Boop-Noddle/20A-bipolar-current-source/kicad/H-bridge/Additionl Testing and Reports/MCC_Testing_Report.pdf

These Tests where done using a + and – 15V supplies.

### 1. The Setpoint and Monitor Voltage Relationship with Col Current

- For this part I Measured the Current in the coils using the Clamp On Ammeter as such:

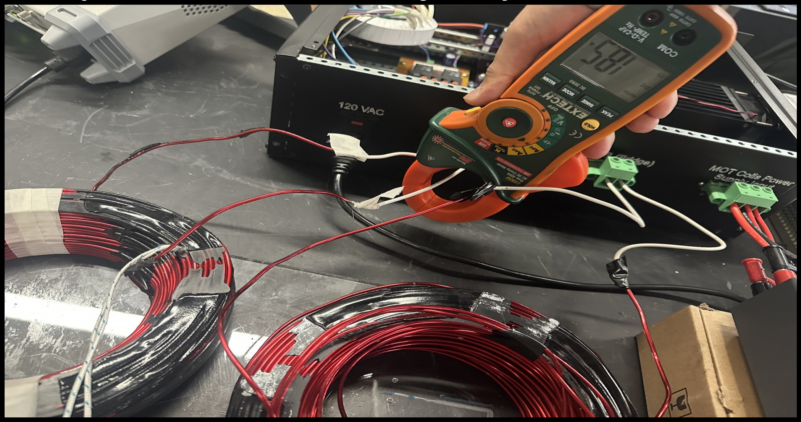
[picture p1: figure]

- Here is the data collected:

Tolerance
Sense
Resistor | 0.01 Ohms | +/- 0.1%

SetPoint
Voltage (V)

Monitor
Voltage (V)

Power Supply
Current (A)

Switching Coil
current (A)

Stationary Coil
Current (A)

Calc \w Sense
Resistor (A)
-1 | 0.21 | 2 | 2.1 | 2.1 | 2.1
-2 | 0.42 | 3.9 | 4 | 3.9 | 4.2
-3 | 0.58 | 5.9 | 6.1 | 5.9 | 5.8
-4 | 0.8 | 7.9 | 7.9 | 8 | 8
-5 | 1.02 | 9.9 | 10.6 | 10.3 | 10.2
-6 | 1.24 | 11.8 | 12.4 | 12.3 | 12.4
-7 | 1.44 | 13.8 | 14.6 | 14.4 | 14.4
-8 | 1.66 | 15.8 | 16.7 | 16.6 | 16.6
-9 | 1.86 | 17.7 | 19 | 18.6 | 18.6
-10 | 1.94 | 18.6 | 19.6 | 19.3 | 19.4

- The Relationship With SetPoint and Coil Current
- The Relationship with Monitor Voltage and Current:
-12 | -10 | -8 | -6 | -4 | -2 | 0

0

f(x) = − 2.04 x + 0.05 | 20
f(x) = − 2.01 x + 0.06 | 15
f(x) = − 2.01 x + 0.11 | 10
| 5

25

f(x) = − 1.91 x + 0.23

Coil Current Vs SetPoint

Power Supply Current (A) | Linear (Power Supply Current (A))
Switching Coil current (A) | Linear (Switching Coil current (A))
Stationary Coil Current (A) | Linear (Stationary Coil Current (A))
Using Sense Resistor (A) | Linear (Using Sense Resistor (A))

SetPoint (V)

Coil Current (A)

-2.5 | -2 | -1.5 | -1 | -0.5 | 0

0

f(x) = − 10.02 x − 0.05 | 20
f(x) = − 10.00 x | 15
f(x) = − 9.49 x + 0.13 | 10
| 5

25

f(x) = − 10.16 x − 0.05

Monitor Voltage Vs Coil Current

Power Supply Current (A) | Linear (Power Supply Current (A))
Switching Coil current (A) | Linear (Switching Coil current (A))
Stationary Coil Current (A) | Linear (Stationary Coil Current (A))
Using Sense Resistor (A) | Linear (Using Sense Resistor (A))

Monitor Voltage (V)

Coil Current (A)

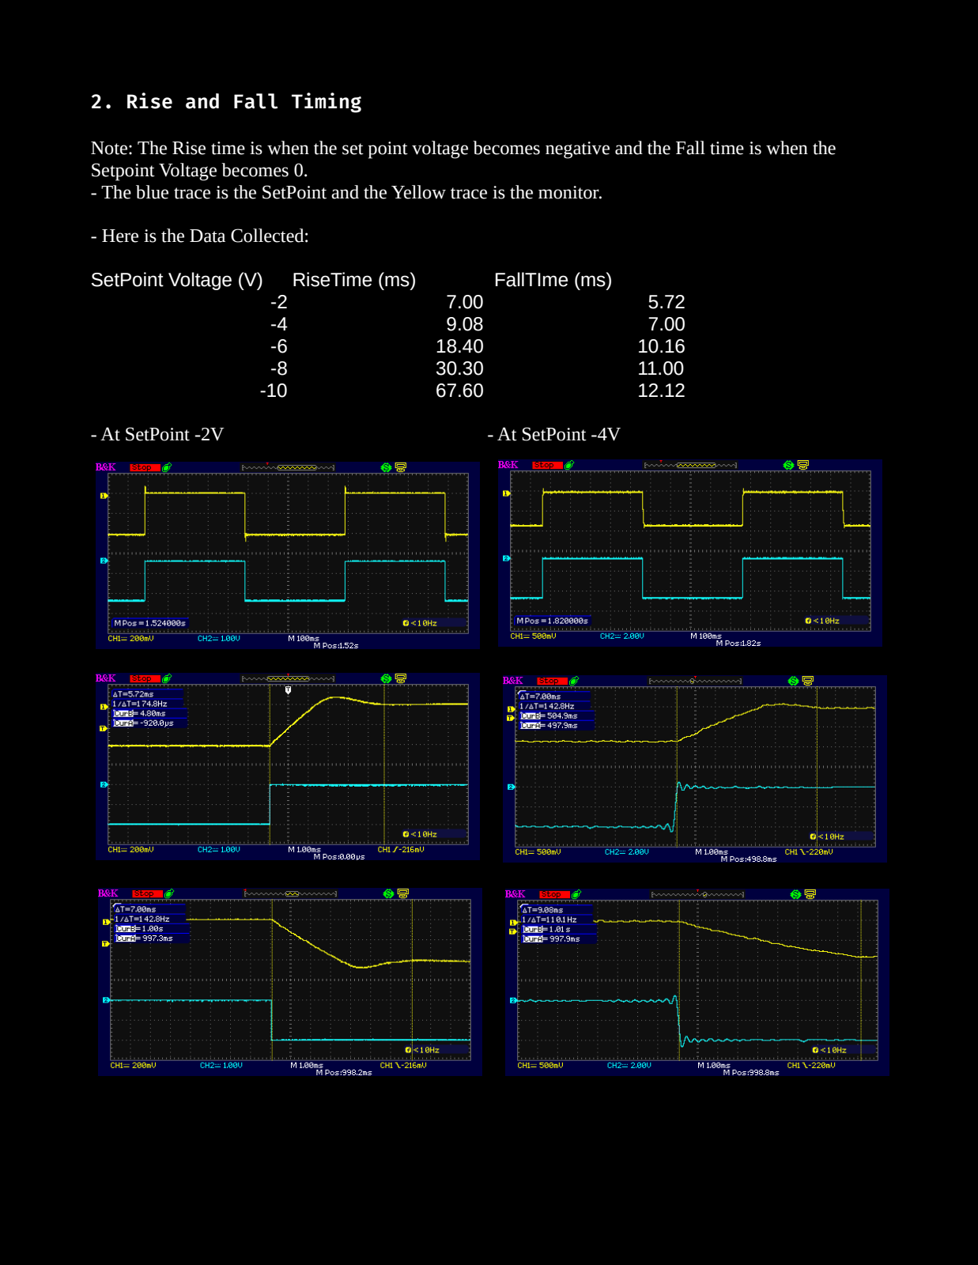
[picture p2: page 3]

### 2. Rise and Fall Timing

Note: The Rise time is when the set point voltage becomes negative and the Fall time is when the Setpoint Voltage becomes 0.
- The blue trace is the SetPoint and the Yellow trace is the monitor.
- Here is the Data Collected:
SetPoint Voltage (V) | RiseTime (ms) | FallTIme (ms)
-2 | 7.00 | 5.72
-4 | 9.08 | 7.00
-6 | 18.40 | 10.16
-8 | 30.30 | 11.00
-10 | 67.60 | 12.12
- At SetPoint -2V | | - At SetPoint -4V

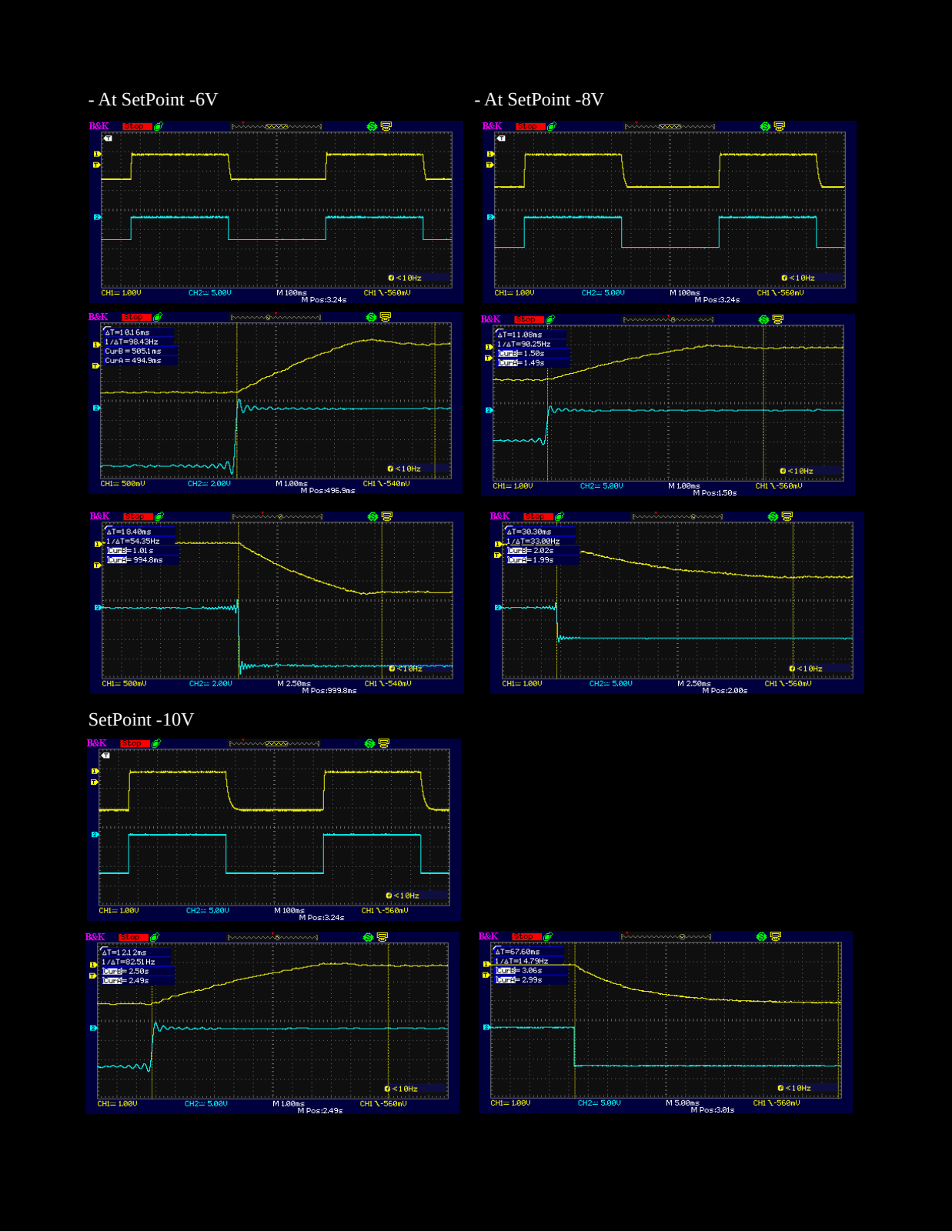
[picture p3: page 4]

- At SetPoint -6V | - At SetPoint -8V

SetPoint -10V

### 3. Portection Mechanism

In the video, I show how the protection mechnism is working. First, the function generator channel 1 is set to output a DC signal at -6V. Then I set channel 2 to output a square wave TTL with a highlevel 3.3V and low level at 0V. Once I turn channel 2 on, you can see that the proctection LED are two different colors and it is flashing because of the square wave TTL. This measn that the current is not allowed to switch rightnow because there ~ 12A flowwing through the coils right now. However, when disconnect the Setpoint the current through the coils drop to 0. The relays start to click and you can see that the protection LED’s are now both the same color. Link: https://youtu.be/TYasHYS4kVA

### 4. Noise From Monitor

Note: These measurments might not be correct, because I didn’t refresh the scope after applying a new Setpoint. To see the noise I applied a DC setpoint, then Set both channels to AC coupling and zoomed into the signal.

- When no setpoint is provided

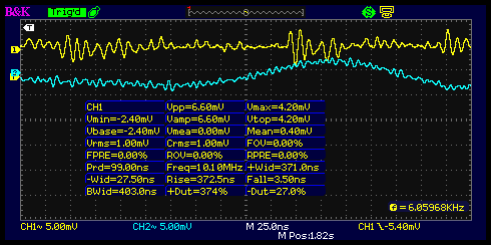
[picture p4: figure]
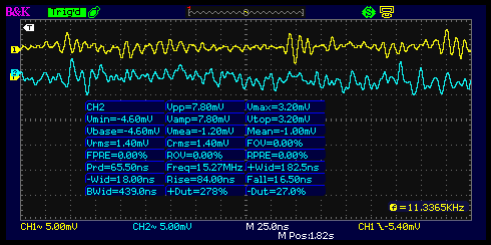
[picture p5: figure]

- At SetPoint -4V

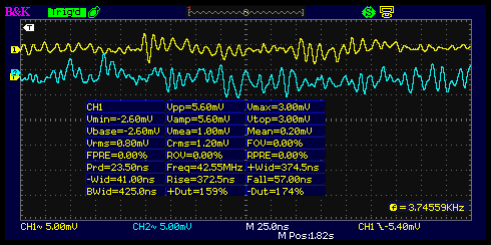
[picture p6: figure]
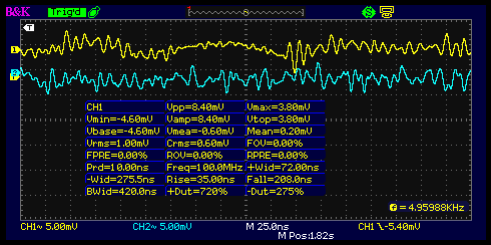
[picture p7: figure]
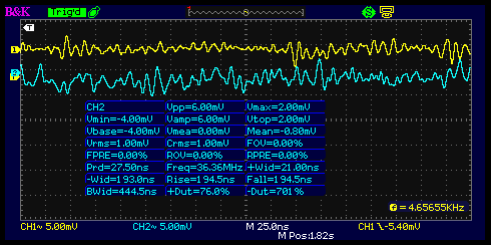
[picture p8: figure]

- At SetPoint -8V

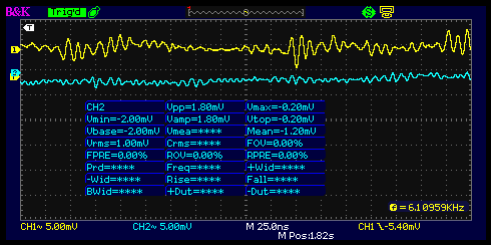
[picture p9: figure]
