Boop-Noddle/20A-bipolar-current-source/kicad/H-bridge/Additionl Testing and Reports/Measuring_L.pdf

April 18, 2025 | Inductance Measurement Report

# Measuring Inductance

## JQI Schine Lab

## April 18, 2025

# 1 Introduction

This report details the procedure and results from an experimental investigation to mea-sure the inductance of a coil constructed from 10 AWG copper wire with approximately 120 turns. Multiple measurement methodologies were employed to compare their accu-racy and reliability. The primary aim was to determine the most effective technique for

accurately measuring inductance while identifying potential sources of measurement error.

# 2 Measurements

The inductance of the coil was measured using four different scenarios. Table 1 summarizes

### the results obtained through these different methodologies. A single measurement of the

DC resistance yielded a value of 0.29 Ω.

### Table 1: Inductance Measurements Using Different Methodologies

Scenario | Method | Measured Inductance
Scenario 0 Oscilloscope pulse decay measurement | 3.80 mH
Scenario 1 RLC circuit with resonance peak analysis | 2.85 mH
Scenario 2 LC circuit with resonance peak analysis | 4.33 mH
Scenario 3 LC circuit with impedance slope method | 4.83 mH

# 3 Brief Overview

A Bode Plot 100 analyzer was utilized to conduct impedance measurements of both RLC and LC circuit configurations to determine the inductance of the coil. The measurements were performed with three different configurations: with a 1 µF capacitor (C1), with a 100 nF capacitor (C2), and without any capacitor. Although the Bode plotter features three channels, only the output channel was employed for this experiment, while channels

1 and 2 remained unused.

### Figure 1: Circuit Diagram for RLC Configuration

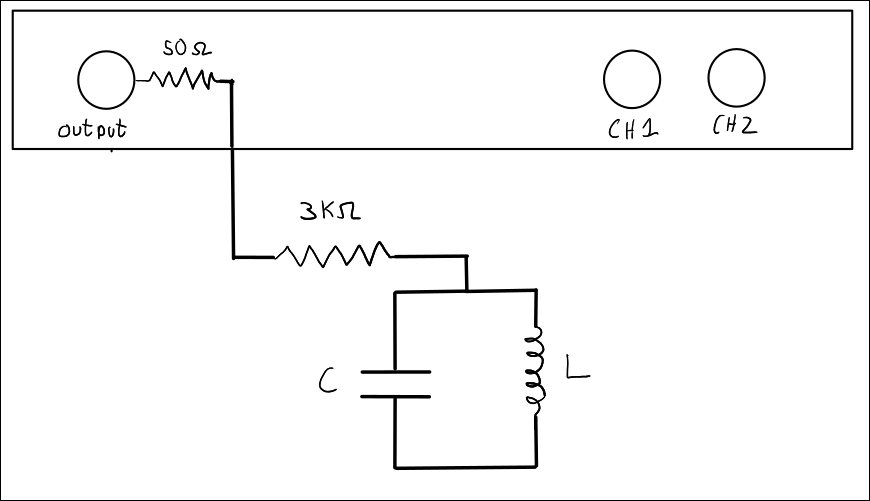
[picture p10: figure]

### Figure 2: Circuit Diagram for LC Configuration

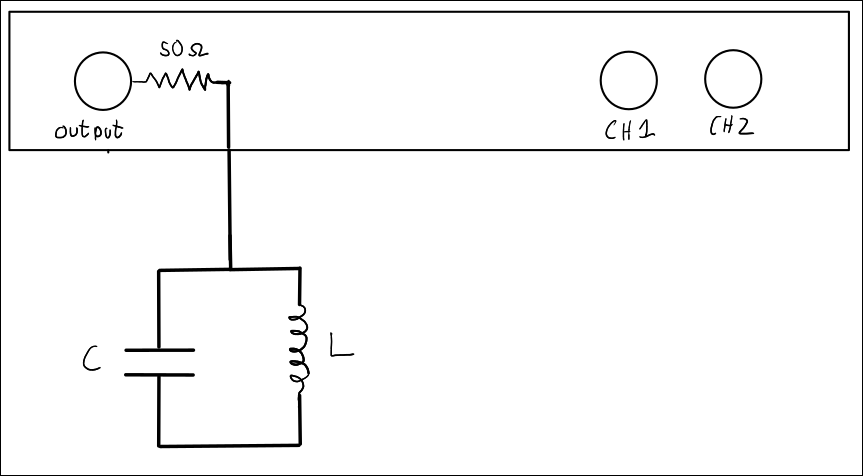
[picture p11: figure]

Since the Bode plotter software refused to connect to my Windows system, I opted to use a Linux environment. An SCPI (Standard Commands for Programmable Instruments) server was used to communicate with the Bode Plot 100 analyzer. Please refer to the automation section in https://www.omicron-lab.com/downloads/bode-analyzer-suite for more details. While the windows software provides a graphical application, the automated data collection enabled precise frequency sweeps and consistent measurement settings

across all test configurations.

# 4 Initial Planning

### Figure 3: Hand-Written Experimental Notes and Planning

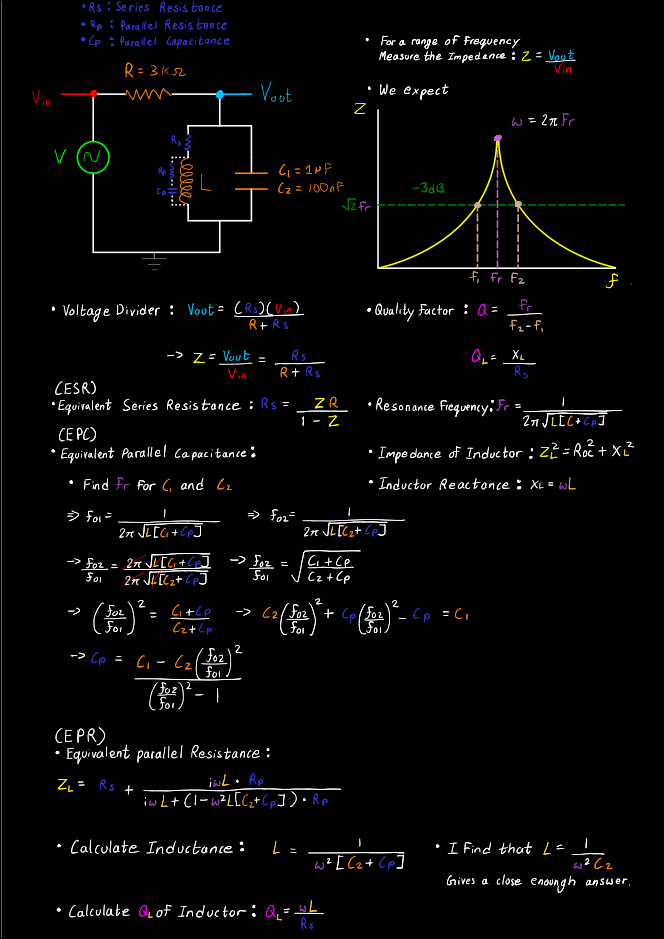
[picture p12: figure]

### The initial experimental approach utilized an RLC circuit with a 3 kΩ resistor to mea-sure the inductance of the coil. The impedance characteristics were measured across a

frequency range from 10 Hz to 1000 kHz.

### Figure 4: Impedance vs. Frequency Plot for RLC Circuit (Log-Log Scale)

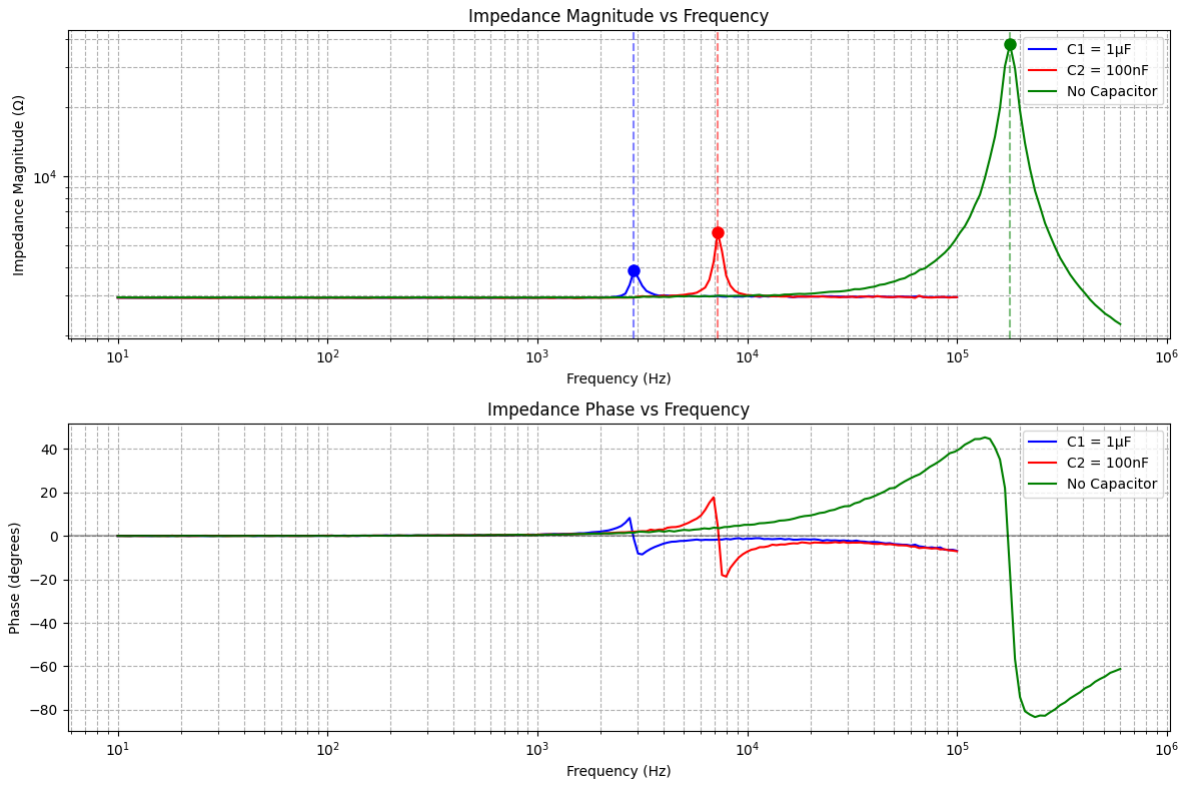
[picture p13: figure]

### Analysis of the RLC circuit data revealed that the resistive component significantly damped the system’s energy, obscuring the expected linear slope in the impedance versus

frequency plot that is characteristic of inductive components. Instead, the resonance peaks

### observed in the frequency response were used to calculate the inductance as detailed in

the hand-written notes (Figure 3).

### However, it became apparent that the Bode Plotter was measuring the impedance of

the entire RLC circuit, not just the inductor. This realization indicated that the calcula-

### tion methodology outlined in the hand-written notes would be applied incorrectly in this scenario, as it assumes that the impedance-frequency relationship is solely attributed to the inductive component. This discovery prompted a shift to an LC circuit configuration

for subsequent measurements.

# 5 Slope Method

### Figure 5: Impedance vs. Frequency Plot for LC Circuit (Log-Log Scale)

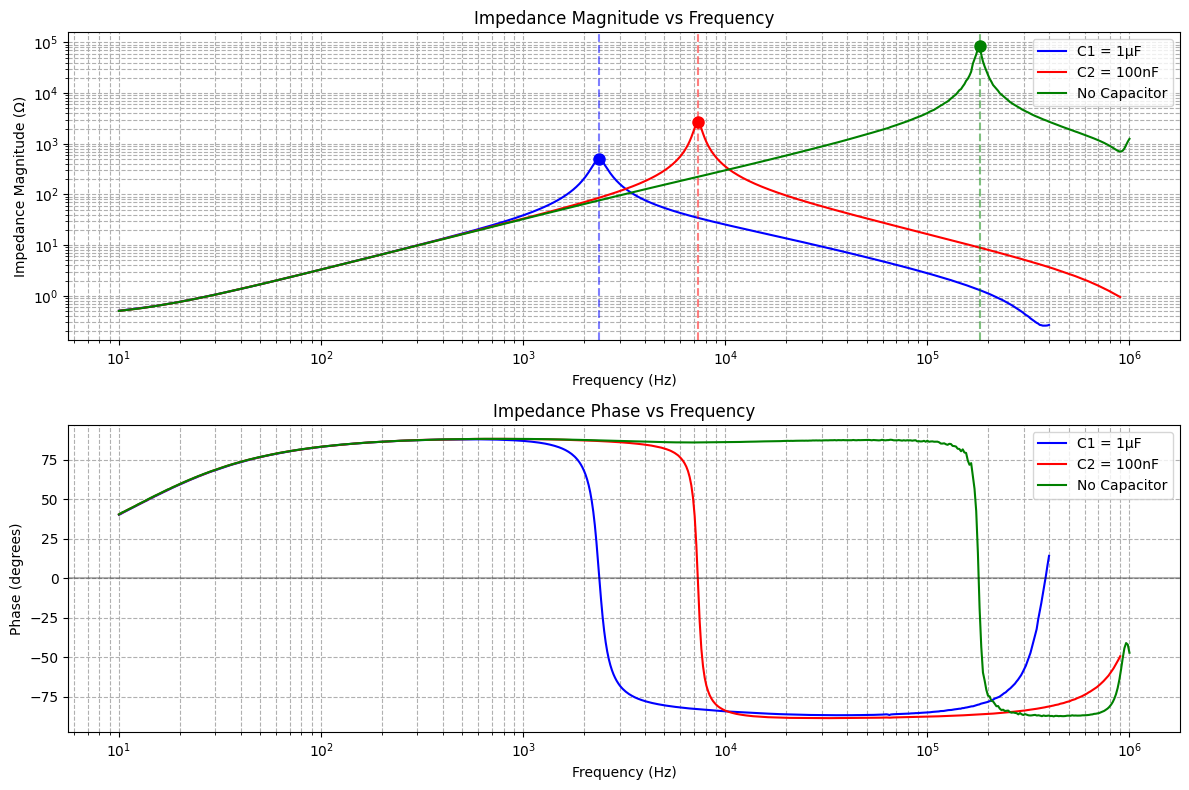
[picture p14: figure]

### The LC circuit configuration provided clearer measurement data, with all three test con-

figurations (C1, C2, and no capacitor) exhibiting the expected linear slope in the log-log

### plot of impedance versus frequency. This linear relationship in the logarithmic domain

confirms the dominant inductive behavior in the frequency range of interest.

### For the inductance calculation, the impedance data from the ”no capacitor” configura-

tion was used, as this represents the purest measurement of the inductor’s characteristics

### without the influence of capacitive elements. The slope of this line corresponds directly to the inductor’s impedance relationship:

ZL = jωL = j2πfL | (1)

### Where the magnitude of impedance increases linearly with frequency:

|ZL| = 2πfL | (2)

### Thus, the inductance can be calculated from the slope of the impedance versus frequency plot:

L =

### slope

2π

(3)

### This calculation yielded an inductance value of 4.83 mH, which is considered the most

accurate measurement from this experimental investigation.

# 6 Rough Analysis

A theoretical estimation of the inductance can be calculated using the physical dimensions

### of the coil:

### - Relative permeability (µr) = 1 (air core)

### - Number of turns (N) = 120

### - Outer diameter = 0.2 m

### - Inner diameter = 0.14 m

### - Depth = 0.04 m

### For a coil with these dimensions, the theoretical inductance can be calculated using the formula for a toroidal coil with rectangular cross-section:

L =

### µ0µrN²A

l

(4)

### Where:

### - µ0 is the permeability of free space 4π × 10⁻⁷

### - A is the cross-sectional area of the coil winding

### - l is the mean path length of the magnetic flux

### Calculating these parameters:

### Mean diameter = 0.2 + 0.14

2

= 0.17 m | (5)

### Cross-sectional area = 0.2 − 0.14

2

× 0.04 = 0.0012 m²
(6)
Mean path length = π × 0.17 = 0.534 m | (7)

### Substituting these values:

L =

### 4π × 10⁻⁷ × 1 × 120² × 0.0012

0.534

(8)

=

4π × 10⁻⁷ × 14400 × 0.0012 0.534

(9)

=

4π × 10⁻⁷ × 17.28
0.534

(10)

≈ 4.07 mH | (11)

### Comparing this theoretical value with our experimental measurements:

### - Scenario 0 (Oscilloscope): 3.80 mH (approximately 6.6% below theory)

### - Scenario 1 (RLC circuit): 2.85 mH (approximately 30.0% below theory)

### - Scenario 2 (LC resonance): 4.33 mH (approximately 6.4% above theory)

### - Scenario 3 (LC slope): 4.83 mH (approximately 18.7% above theory)

### The measurements from Scenarios 0 and 2 most closely align with the theoretical calculation, with deviations of less than 7%. The significant deviation in Scenario 1 (RLC circuit) may confirm the earlier observation that the resistor component affects the

measurement.

# 7 Code

### The following code was implemented in a Jupyter notebook for automated data collection and analysis:

## 7.1 Block 1: SCPI Server Setup

1 | # Block 1: SCPI Server Setup
2 | import pyvisa
3 | import time
4 | import matplotlib . pyplot as plt
5 | import numpy as np
6 | from scipy . optimize import curve_fit

7
8 | # *** TO DO: adapt IP address and SCPI port according to your needs ***
9 | SCPI_server_IP = ’Server IP given by SCPI server ’
10 | SCPI_Port = ’5025 ’
11 | SCPI_timeout = 20000 # milliseconds
12 | VISA_resource_name = ’TCPIP :: ’ + SCPI_server_IP + ’:: ’ + SCPI_Port + ’::
| SOCKET ’

13
14 | # Measurement configuration
15 | Start_frequency = ’10 Hz ’
16 | Stop_frequency = ’1000 KHz ’
17 | Number_of_measurement_points = 601 # the minimum amount of measurement
| points is 2!
18 | Sweep_type = ’LOG ’
19 | Receiver_bandwidth = ’300 Hz ’

20
21 | def perform_measurement () :
22 | start_time = time . time ()
23 | print (
24 | ’Trying to connect to VISA resource : ’ + VISA_resource_name +
25 | ’. Be sure that IP address and port number are correct !’)
26 | visaSession = pyvisa . ResourceManager () . open_resource (
| VISA_resource_name )
27 | visaSession . timeout = SCPI_timeout
28 | visaSession . read_termination = ’\n’
29 | print (’SCPI client connected to SCPI server : ’ + visaSession . query ("
| *IDN?") )

30
31 | lockOk = visaSession . query (": SYST : LOCK :REQ ?")
32 | if lockOk != "1":
33 | print (" Locking was not successful , exiting !")
34 | return None , None , None
35 | else :
36 | print (" Locking was successful !")

37
38 | try :
39 | ### Here comes the measurement configuration data for
| measurement sweep
40 | visaSession . write (’: SENS : FREQ : STAR ’ + Start_frequency )
41 | visaSession . write (’: SENS : FREQ : STOP ’ + str( Stop_frequency ) )
42 | visaSession . write (’: SENS : SWE: POIN ’ + str(
| Number_of_measurement_points ) )
43 | visaSession . write (’: SENS : SWE: TYPE ’ + Sweep_type )
44 | visaSession . write (’: SENS : BAND ’ + Receiver_bandwidth )

45
46 | # configuring ’one - port ’ impedance measurement
47 | visaSession . write (’: CALC : PAR: DEF Z’)
48 | # linear magnitude in Ohms + phase (deg)
49 | visaSession . write (": CALC : FORM SLIN ")

50
51 | # Intializes trigger system to use BUS as source
52 | visaSession . write (’: TRIG : SOUR BUS ’)
53 | # Sets the trigger in continous mode .
54 | visaSession . write (’: INIT : CONT ON ’)
55 | visaSession . write (’: TRIG : SING ’)

56
57 | # This command waits for all pending operations to finish
58 | visaSession . query (’* OPC?’)

59
60 | # Query the measurement results
61 | allResults = visaSession . query (": CALC : DATA : SDAT ?")
62 | frequencyValues = visaSession . query (": SENS : FREQ : DATA ?")

63
64 | # Magnitude and phase from the results
65 | allResults_list_raw = list (map(float , allResults . split (",") ) )
66 | magnitude_raw = allResults_list_raw [0:
Number_of_measurement_points ]
67 | phase_raw = allResults_list_raw [ Number_of_measurement_points :len
( allResults_list_raw ) ]

68
69 | # Same procedure with frequency raw data to list and eventually
to array
70 | freq_list_raw = list (map(float , frequencyValues . split (",") ) )

71
72 | # Printing just the first results of the measurement cycle as
example
73 | print (" Frequency : " + str( freq_list_raw [0]) + " Hz;" + "\
tMagnitude : "
74 | + str( magnitude_raw [0])
75 | + " | ;" + "\ tPhase : " + str( phase_raw [0]) + " | ")

76
77 | except Exception as e :
78 | print ( f"An error occurred : {e}")
79 | return None , None , None

80
81 | finally :
82 | # Release the device
83 | relOK = visaSession . query (’: SYSTem : LOCK : RELease ?’)
84 | visaSession . query (’* OPC?’)
85 | if relOK != "1":
86 | print (" Releasing was not successful , check the availability
of the device !")
87 | else :
88 | print (" Releasing was successful !")

89
90 | visaSession . close ()
91 | print (" --- Measurement time : %s seconds ---" % ( time . time () -
| start_time ) )

92
93 | return freq_list_raw , magnitude_raw , phase_raw

### Listing 1: SCPI Server Setup and Connection

## 7.2 Block 2: First Measurement with C1 = 1F

1 | # Block 2: First Measurement with C1 = 1 F
2 | print (" Running measurement with C1 = 1 F ")
3 | freq1 , mag1 , phase1 = perform_measurement ()
4 | # save to csv file
5 | np . savetxt ("1uF. csv", np . column_stack (( freq1 , mag1 , phase1 ) ) , delimiter =
| ",", header =" Frequency , Magnitude , Phase ", comments =’’)

### Listing 2: First Measurement with C1

## 7.3 Block 3: Second Measurement with C2 = 100nF

1 | # Block 3: Second Measurement with C2 = 100 nF
2 | print ("\ nRunning measurement with C2 = 100 nF")
3 | freq2 , mag2 , phase2 = perform_measurement ()
4 | # save to csv file
5 | np . savetxt (" 100 nF. csv ", np . column_stack (( freq2 , mag2 , phase2 ) ) ,
| delimiter =",", header =" Frequency , Magnitude , Phase ", comments =’’)

### Listing 3: Second Measurement with C2

## 7.4 Block 4: Third Measurement with No Capacitor

1 | # Block 3.1: Third Measurement with no capacitor
2 | print ("\ nRunning measurement with no capacitor ")
3 | freq3 , mag3 , phase3 = perform_measurement ()
4 | # Save to csv file
5 | np . savetxt (" NoCap . csv", np . column_stack (( freq3 , mag3 , phase3 ) ) ,
| delimiter =",", header =" Frequency , Magnitude , Phase ", comments =’’)
6 | plt . figure ()
7 | plt . loglog ( freq3 , mag3 )
8 | plt . show ()

### Listing 4: Third Measurement with No Capacitor

## 7.5 Block 5: Analysis and Plotting

1 | # Block 4: Analysis and Plotting
2 | import numpy as np
3 | import matplotlib . pyplot as plt

4
5 | fre1 = np . loadtxt ("1uF.csv ", delimiter =",", skiprows =1)
6 | fre2 = np . loadtxt ("100 nF.csv ", delimiter =",", skiprows =1)
7 | fre3 = np . loadtxt (" NoCap .csv ", delimiter =",", skiprows =1)
8 | freq1 = [ n for n in fre1 [: ,0]]
9 | mag1 = [ n for n in fre1 [: ,1]]
10 | phase1 = [ n for n in fre1 [: ,2]]
11 | freq2 = [ n for n in fre2 [: ,0]]
12 | mag2 = [ n for n in fre2 [: ,1]]
13 | phase2 = [ n for n in fre2 [: ,2]]
14 | freq3 = [ n for n in fre3 [: ,0]]
15 | mag3 = [ n for n in fre3 [: ,1]]
16 | phase3 = [ n for n in fre3 [: ,2] ]

18 # Find resonant frequencies by finding MAXIMUM impedance magnitude (for parallel resonance )
19 | # Find maximum impedance ( peak in the bode plot )
20 | max_idx1 = mag1 . index (max( mag1 ) )
21 | fr1 = freq1 [ max_idx1 ]
22 | z_max1 = mag1 [ max_idx1 ]
23 | print ( f" Resonant frequency (C1): {fr1 :.2f} Hz , Maximum impedance : {
z_max1 :.2 f} | ")

24
25 | # Find maximum impedance ( peak in the bode plot )
26 | max_idx2 = mag2 . index (max( mag2 ) )
27 | fr2 = freq2 [ max_idx2 ]
28 | z_max2 = mag2 [ max_idx2 ]
29 | print ( f" Resonant frequency (C2): {fr2 :.2f} Hz , Maximum impedance : {
z_max2 :.2 f} | ")

30
31 | # Find maximum impedance ( peak in the bode plot )
32 | max_idx3 = mag3 . index (max( mag3 ) )
33 | fr3 = freq3 [ max_idx3 ]
34 | z_max3 = mag3 [ max_idx3 ]
35 | print ( f" Resonant frequency (No Capacitor ): {fr3 :.2f} Hz , Maximum
impedance : { z_max3 :.2f} | ")

36

37
38 | ’’’
39 | Invalid way of calculating the EPC and L

40
41 | # Calculate component values if resonant frequencies were found
42 | if fr1 and fr2:
43 | # Given values
44 | C1 = 1e -6 | # 1 F
45 | C2 = 100e -9 | # 100 nF

46
47 | # Calculate inductance using equation
48 | # fr = 1/(2 | (L[C+Cp ]))
49 | # Two measurements with different capacitors allow us to solve for L

50
51 | # Using the formula derived
52 | # (fr2/fr1)^2 = (C1+Cp)/( C2+Cp)
53 | # Solve for Cp ( Equivalent Parallel Capacitance )
54 | ratio_sq = (fr2/fr1)**2
55 | Cp = (C1 - ratio_sq * C2) / ( ratio_sq - 1)
56 | print (f" Equivalent Parallel Capacitance (Cp): {Cp *1 e9 :.2f} nF ")

57
58 | # Calculate inductance using fr1 and total capacitance (C1 + Cp)
59 | L = 1 / ((2 * np.pi * fr1)**2 * (C1 + Cp))
60 | print (f" Inductance (L): {L*1 e3 :.2f} mH ")

61
62 | # Calculate Slope of the plot at 100 Hz to 300 Hz by fitting to a line

63

64
65 | if fr3:
66 | L_wc = 1 / (2 * np.pi * fr3 )
67 | print (f" Inductance without cap ( L_wc ): {L*1 e3 :.2f} mH ")

68
69 | # using fr = 1/(2 | (LC)) where Cp = C
70 | Cp_wc = 1 / (4 * (np.pi **2) * (fr3 **2) * L_wc )
71 | print (f" Parasitic Capacitance ( Cp_wc ): { Cp_wc *1 e9 :.2f} nF ")

72 | ’’’
73 | # Use the slope of the plot to calculate the inductance
74 | def calculate_inductance_from_slope ( freq , mag , freq_start , freq_end ) :
75 | # Find indices for the frequency range
76 | indices = [ i for i , f in enumerate ( freq ) if freq_start <= f <=
freq_end ]

77
78 | # Extract the relevant portions of the data
79 | freq_range = [ freq [ i ] for i in indices ]
80 | mag_range = [ mag [ i ] for i in indices ]

81
82 | # Fit a line to the data
83 | coeffs = np . polyfit ( freq_range , mag_range , 1)
84 | slope = coeffs [0]
85 | intercept = coeffs [1]

86
87 | # For an inductor , |Z| = | L | = 2 fL
88 | # L = slope / (2 | )
89 | L = slope / (2 * np . pi )

90
91 | return L , slope , intercept , freq_range , mag_range

92
93 | # Set frequency range for analysis
94 | freq_start = 10**2 | # Hz
95 | freq_end = 10**4 | # Hz

96
97 | # Choose which dataset to use ( ’C1 ’, ’C2 ’, or ’noCapacitor ’)
98 | dataset = ’noCapacitor ’ | # Change this to use different dataset

99
100 | # Calculate inductance based on chosen dataset
101 | if dataset == ’C1 ’:
102 | L , slope , intercept , freq_range , mag_range =
calculate_inductance_from_slope (
103 | freq1 , mag1 , freq_start , freq_end )
104 | label = "C1 = 1 F "
105 | elif dataset == ’C2 ’:
106 | L , slope , intercept , freq_range , mag_range =
calculate_inductance_from_slope (
107 | freq2 , mag2 , freq_start , freq_end )
108 | label = "C2 = 100 nF"
109 | elif dataset == ’noCapacitor ’:
110 | L , slope , intercept , freq_range , mag_range =
calculate_inductance_from_slope (
111 | freq3 , mag3 , freq_start , freq_end )
112 | label = "No Capacitor "

113
114 | # Print results
115 | if L is not None :
116 | print ( f"\ nInductance calculation using { label } ( slope between {
freq_start } -{ freq_end } Hz):")
117 | print ( f" | Linear fit: |Z| = { slope :.4f}f + { intercept :.4f}")
118 | print ( f" | Slope : { slope :.4f} | /Hz")
119 | print ( f" | Inductance : {L*1 e3 :.2f} mH")
120 | else :
121 | print ( f" Could not calculate inductance for { label } in range {
freq_start } -{ freq_end } Hz")

122
123 | # w = 2 f | measured DC Resistance = mdr # Ohm

124 | mdr = 0.29
125 | w1 = 2 * np . pi * fr1
126 | w2 = 2 * np . pi * fr2
127 | w3 = 2 * np . pi * fr3
128 | Q1 = w1 * L / mdr
129 | print ("Q factor with C1 = 1 F : ", Q1 )
130 | Q2 = w2 * L / mdr
131 | print ("Q factor with C2 = 100 nF: ", Q2 )
132 | Q3 = w3 * L / mdr
133 | print ("Q factor with no capacitor : ", Q3 )

134
135 | # Plot the results
136 | plt . figure ( figsize =(12 , 8) )

137
138 | # Plot 1: Magnitude vs Frequency
139 | plt . subplot (2 , 1 , 1)
140 | if freq1 and mag1 :
141 | plt . loglog ( freq1 , mag1 , ’b-’, label =’C1 = 1 F ’)
142 | plt . axvline ( x = fr1 , color =’b’, linestyle =’--’, alpha =0.5)
143 | plt . plot ( fr1 , z_max1 , ’bo ’, markersize =8)

144

145
146 | if freq2 and mag2 :
147 | plt . loglog ( freq2 , mag2 , ’r-’, label =’C2 = 100 nF ’)
148 | plt . axvline ( x = fr2 , color =’r’, linestyle =’--’, alpha =0.5)
149 | plt . plot ( fr2 , z_max2 , ’ro ’, markersize =8)

150
151 | if freq3 and mag3 :
152 | plt . loglog ( freq3 , mag3 , ’g-’, label =’No Capacitor ’)
153 | plt . axvline ( x = fr3 , color =’g’, linestyle =’--’, alpha =0.5)
154 | plt . plot ( fr3 , z_max3 , ’go ’, markersize =8)

155

156
157 | plt . grid ( True , which =" both ", ls =" --")
158 | plt . xlabel (’Frequency (Hz)’)
159 | plt . ylabel (’Impedance Magnitude ( | )’)
160 | plt . title (’Impedance Magnitude vs Frequency ’)
161 | plt . legend ()

162
163 | # Plot 2: Phase vs Frequency
164 | plt . subplot (2 , 1 , 2)
165 | if freq1 and phase1 :
166 | plt . semilogx ( freq1 , phase1 , ’b-’, label =’C1 = 1 F ’)
167 | if freq2 and phase2 :
168 | plt . semilogx ( freq2 , phase2 , ’r-’, label =’C2 = 100 nF ’)
169 | if freq3 and phase3 :
170 | plt . semilogx ( freq3 , phase3 , ’g-’, label =’No Capacitor ’)
171 | plt . grid ( True , which =" both ", ls =" --")
172 | plt . xlabel (’Frequency (Hz)’)
173 | plt . ylabel (’Phase ( degrees )’)
174 | plt . title (’Impedance Phase vs Frequency ’)
175 | plt . axhline ( y =0 , color =’k’, linestyle =’-’, alpha =0.3)
176 | plt . legend ()
177 | plt . tight_layout ()
178 | plt . show ()

### Listing 5: Analysis and Plotting
