Boop-Noddle/20A-bipolar-current-source/kicad/H-bridge/Additionl Testing and Reports/RiseFallScopeData/S10.CSV

Source | CH1 | CH2
Second | Volt | Volt
3.99400000000 | -0.04000 | 0.00
3.99439975000 | -0.04000 | 0.00
3.99479975000 | -0.04000 | -0.20000
3.99520000000 | -0.04000 | -0.20000
3.99560000000 | -0.04000 | 0.00
3.99599975000 | -0.04000 | -0.20000
3.99640000000 | -0.04000 | -0.20000
3.99680000000 | -0.04000 | 0.00
3.99720000000 | -0.04000 | -0.20000
3.99759975000 | -0.04000 | 0.00
3.99800000000 | -0.04000 | 0.00
3.99840000000 | -0.04000 | 0.00
3.99879975000 | -0.04000 | -0.20000
3.99919975000 | -0.04000 | -0.20000
3.99960000000 | -0.04000 | 0.00
4.00000000000 | -0.04000 | 0.00
4.00040000000 | -0.08000 | 0.00
4.00080025000 | -0.04000 | 0.00
4.00119975000 | -0.04000 | 0.00
4.00159975000 | -0.04000 | -0.20000
4.00199975000 | -0.04000 | -0.20000
4.00240000000 | -0.04000 | 0.00
4.00280000000 | -0.04000 | 0.00
4.00320000000 | -0.08000 | -0.20000
4.00360000000 | -0.04000 | 0.00
4.00399975000 | -0.04000 | 0.00
4.00439975000 | -0.04000 | 0.00
4.00479975000 | -0.04000 | 0.00
4.00520000000 | -0.04000 | -0.20000
4.00560000000 | -0.04000 | -0.20000
4.00600000000 | -0.04000 | 0.00
4.00640000000 | -0.04000 | -0.20000
4.00679975000 | -0.08000 | 0.00
4.00719975000 | -0.08000 | -0.20000
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
