Boop-Noddle/20A-bipolar-current-source/kicad/H-bridge/Additionl Testing and Reports/RiseFallScopeData/S2.CSV

Source | CH1 | CH2
Second | Volt | Volt
-1.06600000000 | 0.02400 | 0.00
-1.06559987500 | 0.02400 | -0.04000
-1.06520000000 | 0.02400 | 0.00
-1.06480000000 | 0.02400 | -0.04000
-1.06440000000 | 0.02400 | 0.00
-1.06400000000 | 0.02400 | -0.04000
-1.06360000000 | 0.02400 | 0.00
-1.06320000000 | 0.02400 | 0.00
-1.06279987500 | 0.02400 | 0.00
-1.06240000000 | 0.02400 | -0.04000
-1.06199987500 | 0.02400 | 0.00
-1.06160000000 | 0.02400 | 0.00
-1.06120000000 | 0.02400 | 0.00
-1.06080000000 | 0.02400 | 0.00
-1.06040000000 | 0.02400 | 0.00
-1.06000000000 | 0.02400 | 0.00
-1.05960000000 | 0.02400 | 0.00
-1.05919987500 | 0.02400 | 0.00
-1.05880000000 | 0.02400 | -0.04000
-1.05839987500 | 0.02400 | 0.00
-1.05800000000 | 0.02400 | 0.00
-1.05760000000 | 0.02400 | 0.00
-1.05720000000 | 0.02400 | 0.00
-1.05680000000 | 0.02400 | 0.00
-1.05640000000 | 0.02400 | 0.00
-1.05600000000 | 0.02400 | -0.04000
-1.05559987500 | 0.02400 | 0.00
-1.05520000000 | 0.02400 | 0.00
-1.05479987500 | 0.02400 | 0.00
-1.05440000000 | 0.02400 | 0.00
-1.05400000000 | 0.03200 | 0.00
-1.05360000000 | 0.02400 | -0.04000
-1.05320000000 | 0.02400 | 0.00
-1.05280000000 | 0.02400 | 0.00
-1.05240000000 | 0.02400 | 0.00
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
