Boop-Noddle/20A-bipolar-current-source/kicad/H-bridge/Additionl Testing and Reports/RiseFallScopeData/S4.CSV

Source | CH1 | CH2
Second | Volt | Volt
-0.99600000000 | 0.04000 | -0.08000
-0.99560000000 | 0.04000 | 0.00
-0.99520000000 | 0.04000 | 0.00
-0.99480000000 | 0.02000 | 0.00
-0.99439993750 | 0.02000 | 0.00
-0.99399993750 | 0.02000 | 0.00
-0.99359993750 | 0.02000 | 0.00
-0.99320000000 | 0.04000 | 0.00
-0.99280000000 | 0.04000 | -0.08000
-0.99240000000 | 0.02000 | -0.08000
-0.99200000000 | 0.02000 | -0.08000
-0.99160000000 | 0.02000 | -0.08000
-0.99120000000 | 0.02000 | -0.08000
-0.99079993750 | 0.02000 | -0.08000
-0.99039993750 | 0.02000 | -0.08000
-0.98999993750 | 0.02000 | 0.00
-0.98960000000 | 0.02000 | -0.08000
-0.98920000000 | 0.02000 | -0.08000
-0.98880000000 | 0.04000 | 0.00
-0.98840000000 | 0.04000 | -0.08000
-0.98800000000 | 0.02000 | -0.08000
-0.98760000000 | 0.04000 | 0.00
-0.98719993750 | 0.02000 | -0.08000
-0.98679993750 | 0.04000 | -0.08000
-0.98639993750 | 0.04000 | -0.08000
-0.98600000000 | 0.04000 | -0.08000
-0.98560000000 | 0.02000 | -0.08000
-0.98520000000 | 0.02000 | -0.08000
-0.98480000000 | 0.02000 | -0.08000
-0.98440000000 | 0.02000 | 0.00
-0.98399993750 | 0.02000 | 0.00
-0.98359993750 | 0.02000 | -0.08000
-0.98319993750 | 0.02000 | 0.00
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
