Boop-Noddle/20A-bipolar-current-source/kicad/H-bridge/Additionl Testing and Reports/RiseFallScopeData/S6.CSV

Source | CH1 | CH2
Second | Volt | Volt
-0.98600000000 | 0.02000 | -0.08000
-0.98560000000 | 0.02000 | -0.08000
-0.98520000000 | 0.02000 | 0.00
-0.98480000000 | 0.02000 | 0.00
-0.98440000000 | 0.02000 | -0.08000
-0.98399993750 | 0.02000 | -0.08000
-0.98359993750 | 0.02000 | 0.00
-0.98319993750 | 0.02000 | -0.08000
-0.98279993750 | 0.02000 | 0.00
-0.98240000000 | 0.02000 | -0.08000
-0.98200000000 | 0.02000 | 0.00
-0.98160000000 | 0.02000 | -0.08000
-0.98120000000 | 0.02000 | 0.00
-0.98080000000 | 0.02000 | 0.00
-0.98039993750 | 0.02000 | -0.08000
-0.97999993750 | 0.04000 | 0.00
-0.97959993750 | 0.02000 | -0.08000
-0.97919993750 | 0.02000 | 0.00
-0.97880000000 | 0.02000 | -0.08000
-0.97840000000 | 0.02000 | -0.08000
-0.97800000000 | 0.02000 | -0.08000
-0.97760000000 | 0.02000 | -0.08000
-0.97720000000 | 0.02000 | -0.08000
-0.97679993750 | 0.02000 | -0.08000
-0.97639993750 | 0.02000 | -0.08000
-0.97599993750 | 0.02000 | -0.08000
-0.97560000000 | 0.02000 | -0.08000
-0.97520000000 | 0.04000 | -0.08000
-0.97480000000 | 0.04000 | -0.08000
-0.97440000000 | 0.04000 | 0.00
-0.97400000000 | 0.02000 | -0.08000
-0.97360000000 | 0.04000 | -0.08000
-0.97319993750 | 0.02000 | -0.08000
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
