Boop-Noddle/20A-bipolar-current-source/kicad/H-bridge/Additionl Testing and Reports/RiseFallScopeData/S8.CSV

Source | CH1 | CH2
Second | Volt | Volt
1.51400000000 | -0.04000 | -0.20000
1.51440000000 | -0.04000 | -0.20000
1.51480000000 | -0.04000 | 0.00
1.51520000000 | -0.04000 | 0.00
1.51560000000 | -0.04000 | 0.00
1.51599987500 | -0.04000 | 0.00
1.51640000000 | -0.04000 | 0.20000
1.51679987500 | -0.04000 | 0.00
1.51720000000 | -0.04000 | 0.00
1.51760000000 | -0.04000 | 0.00
1.51800000000 | -0.04000 | -0.20000
1.51840000000 | -0.04000 | 0.00
1.51880000000 | -0.04000 | 0.00
1.51920000000 | -0.04000 | 0.00
1.51959987500 | -0.04000 | -0.20000
1.52000000000 | -0.04000 | 0.00
1.52039987500 | -0.04000 | 0.00
1.52080000000 | -0.04000 | 0.00
1.52120000000 | -0.04000 | 0.00
1.52160000000 | -0.04000 | 0.00
1.52200000000 | -0.04000 | 0.00
1.52239987500 | -0.04000 | 0.00
1.52280000000 | -0.04000 | 0.00
1.52319987500 | -0.04000 | 0.00
1.52360000000 | -0.04000 | 0.00
1.52399987500 | -0.04000 | 0.00
1.52440000000 | -0.04000 | 0.00
1.52480000000 | -0.04000 | 0.00
1.52520000000 | -0.04000 | 0.00
1.52560000000 | -0.04000 | 0.00
1.52599987500 | 0.00 | 0.00
1.52640000000 | -0.04000 | 0.00
1.52679987500 | -0.04000 | -0.20000
1.52720000000 | -0.04000 | 0.00
1.52759987500 | -0.04000 | 0.00
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
