Boop-Noddle/20A-bipolar-current-source/kicad/H-bridge/Additionl Testing and Reports/MeausringInductance/Pulse_Decay.png

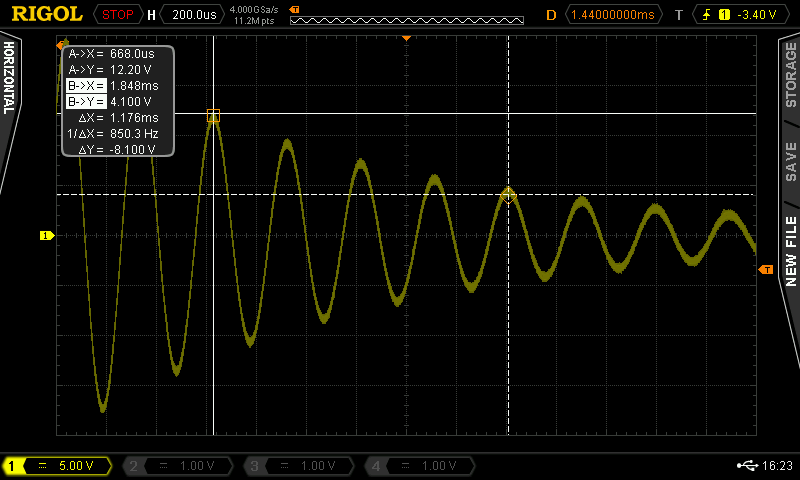
kicad/H-bridge/Additionl Testing and Reports/MeausringInductance/Pulse_Decay.png
