Boop-Noddle/20A-bipolar-current-source/kicad/H-bridge/Additionl Testing and Reports/UnipolarFetBoard/Fet_with_Network.png

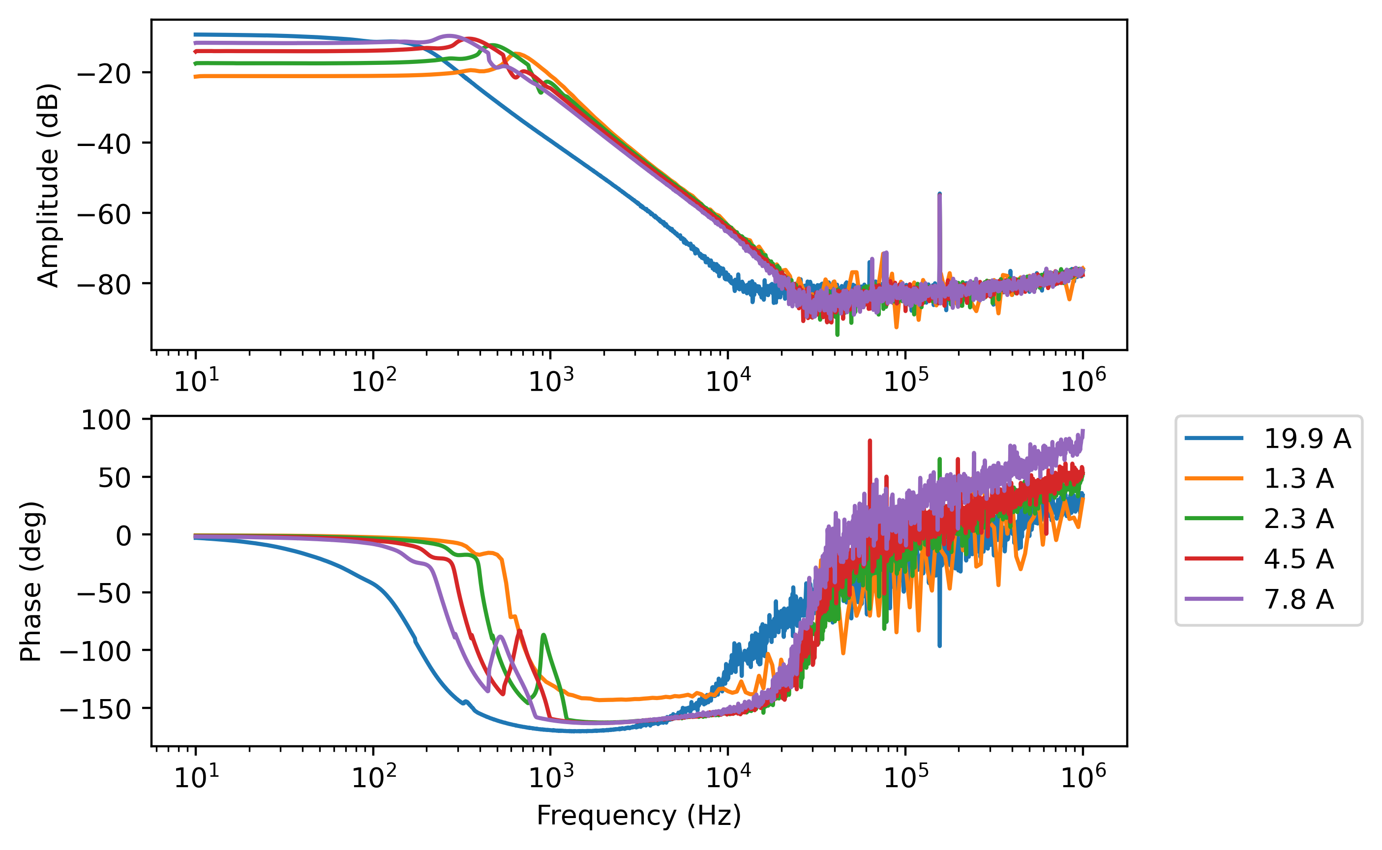
kicad/H-bridge/Additionl Testing and Reports/UnipolarFetBoard/Fet_with_Network.png
