Boop-Noddle/20A-bipolar-current-source/kicad/H-bridge/Additionl Testing and Reports/MeausringInductance/InductorNotes_annotated.pdf

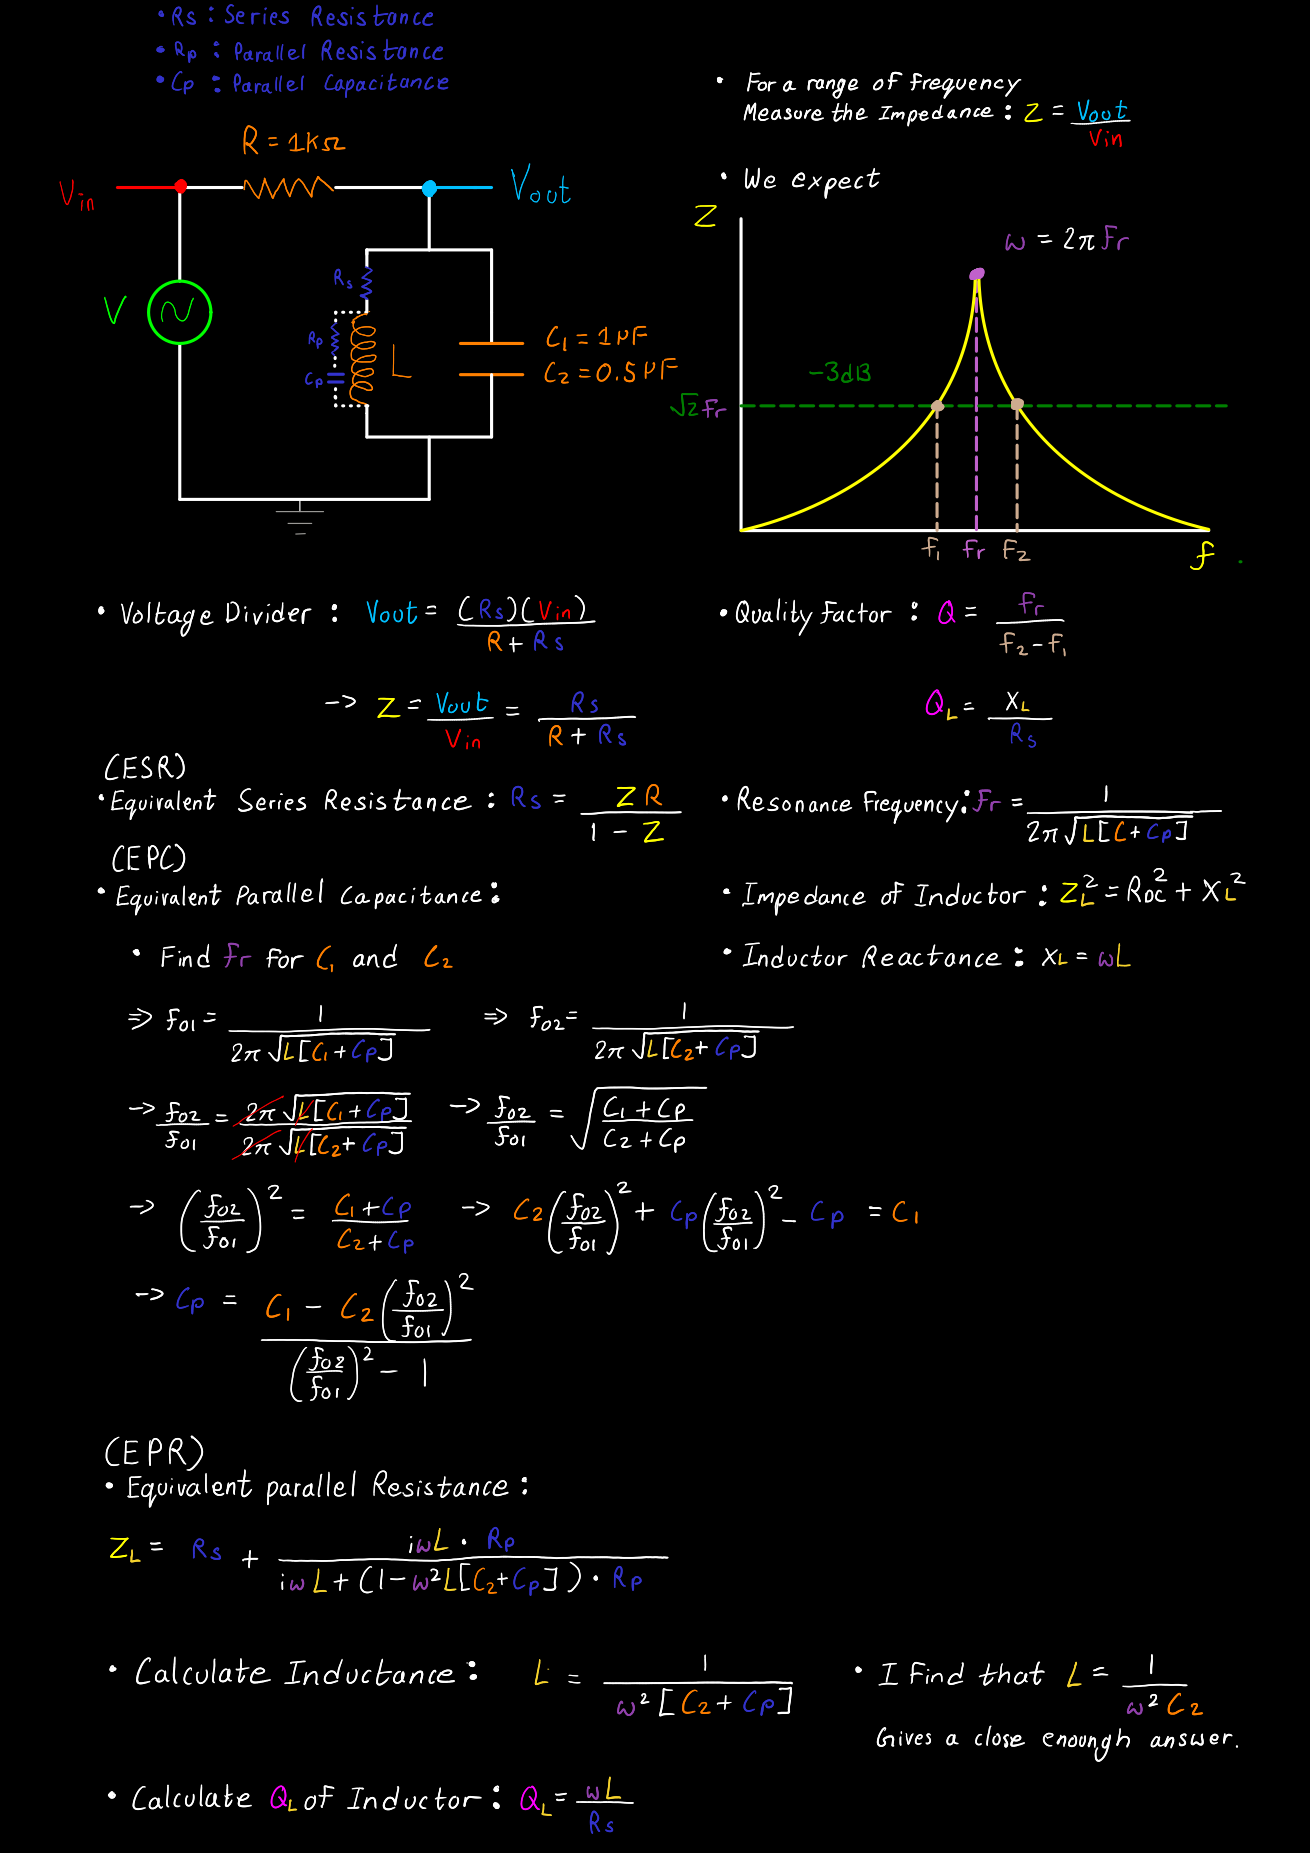
[picture p29: page 1]
