Boop-Noddle/20A-bipolar-current-source/kicad/Controller_supply/Controller_supply.kicad_pcb

## KiCad design kicad/Controller_supply/Controller_supply.kicad_pcb (2024-07-29)

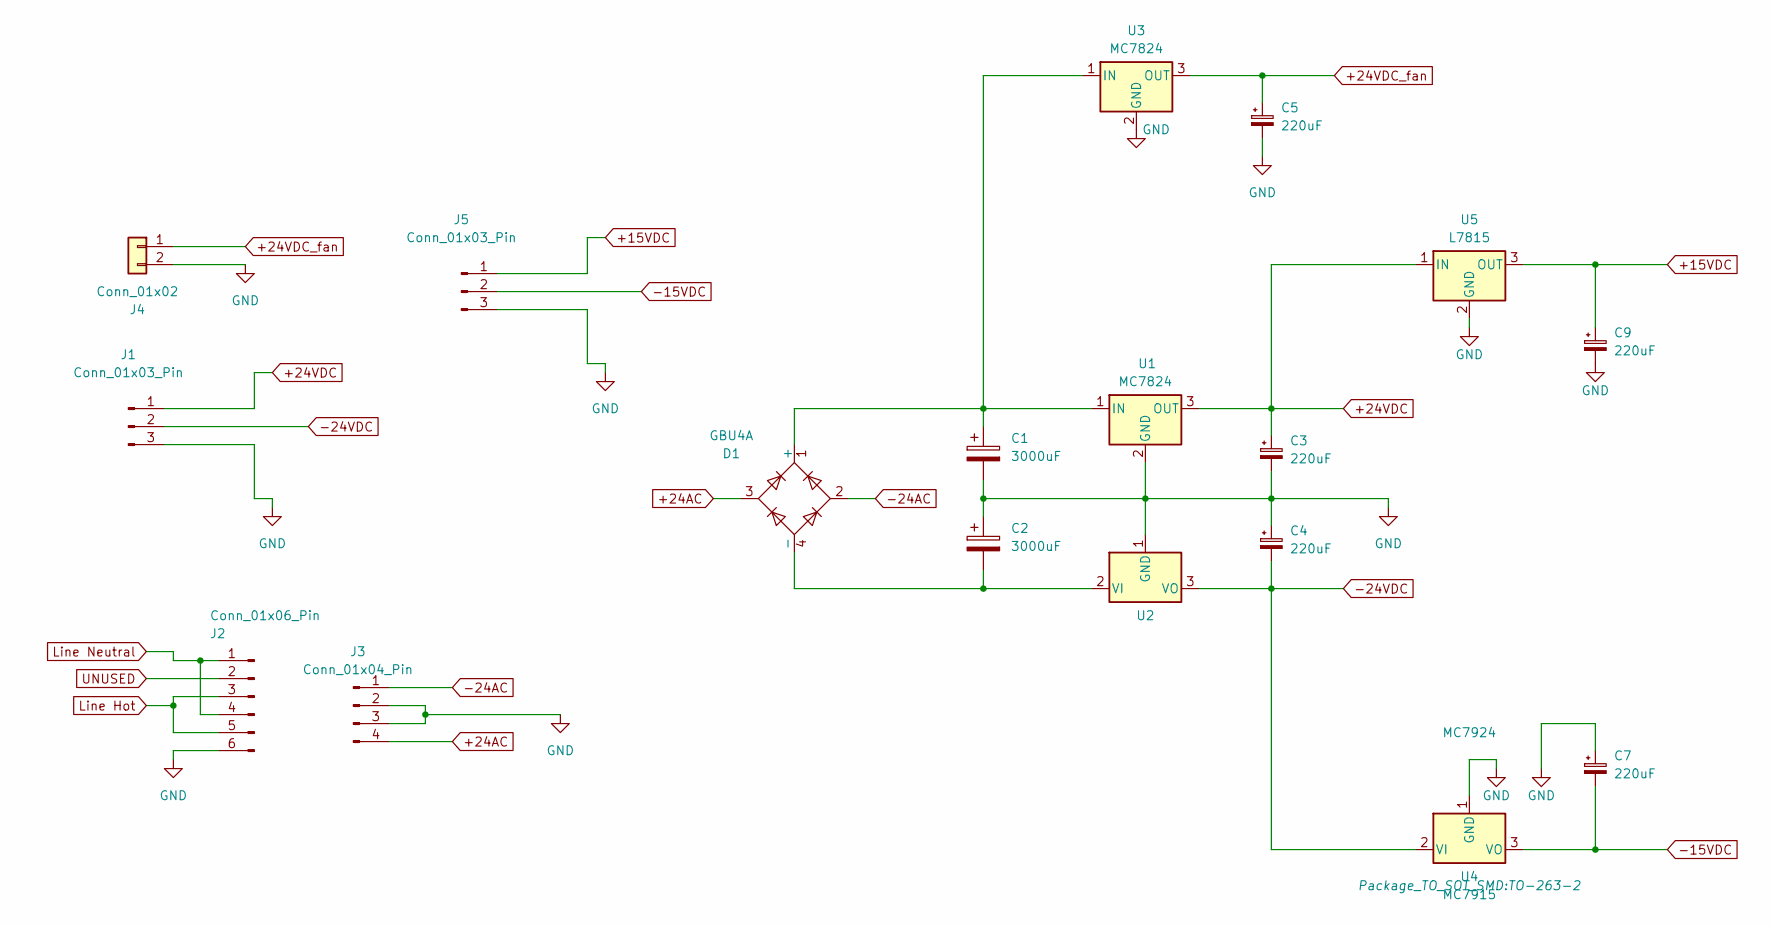
[picture p30: schematic Controller_supply.kicad_sch]

Parts:
C1, C2: 3000uF; CP_Elec_18x22; MPN EEE-FK1V302SV; DIGIKEY PARTNO P122523CT-ND
C3, C4, C5, C7, C9: 220uF; CP_Elec_10x10.5; MPN EEE-FK1H221P; DIGIKEY PARTNO PCE3812CT-ND
D1: GBU4A; Diode_Bridge_Vishay_GBU; MPN GBU4A; DIGIKEY PARTNO GBU4A-ND
J1, J5: Conn_01x03_Pin; PhoenixContact_GMSTBA_2,5_3-G-7,62_1x03_P7.62mm_Horizontal
J2: Conn_01x06_Pin
J3: Conn_01x04_Pin; Generic_pin-to-housing_1x04_P5.00mm_Horizontal
J4: Conn_01x02; Generic_7x7.5mm-footprt_1x02_P3.50mm_Horizontal
U1, U3: MC7824; TO-263-2; MPN MC7824CD2TR4G; DIGIKEY PARTNO MC7824CD2TR4GOSCT-ND
U2: MC7924; TO-263-2; MPN MC7924CD2TG; DIGIKEY PARTNO MC7924CD2TG-ND
U4: MC7915; TO-263-2
U5: L7815; TO-263-2

Connections:
+15VDC: C9.1, J5.1, U5.3 (OUT)
+24AC: D1.3, J3.4
+24VDC: C3.1, J1.1, U1.3 (OUT), U5.1 (IN)
+24VDC_fan: C5.1, J4.1, U3.3 (OUT)
-15VDC: C7.2, J5.2, U4.3 (VO)
-24AC: D1.2, J3.1
-24VDC: C4.2, J1.2, U2.3 (VO), U4.2 (VI)
GND: C1.2, C2.1, C3.2, C4.1, C5.2, C7.1, C9.2, J1.3, J2.6, J3.2, J3.3, J4.2, J5.3, U1.2 (GND), U2.1 (GND), U3.2 (GND), U4.1 (GND), U5.2 (GND)
unnamed: C1.1, D1.1 (+), U1.1 (IN), U3.1 (IN)
unnamed: C2.2, D1.4 (-), U2.2 (VI)
unnamed: J2.1, J2.4
unnamed: J2.3, J2.5

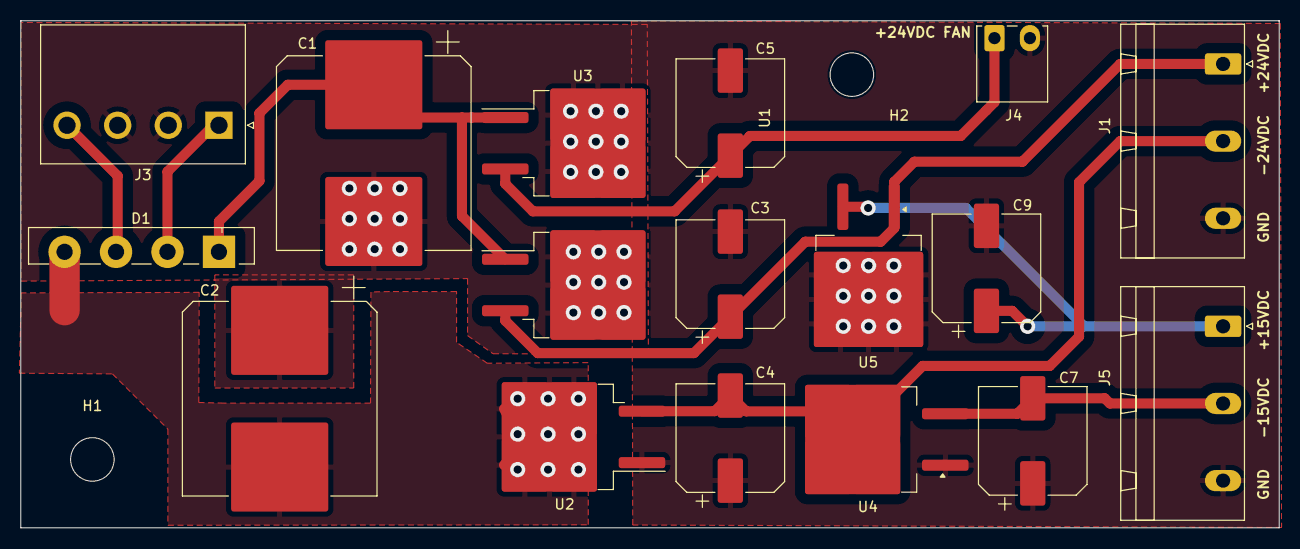
[picture p31: board Controller_supply.kicad_pcb from above]

Board: 2 copper layers, 124.3 x 50.1 mm, 19 parts (0 on the bottom side), 10 nets.

Other parts of the board:
H1, H2: MountingHole_4.3mm_M4
