Boop-Noddle/20A-bipolar-current-source/kicad/Unipolar_FET_Board/Unipolar_FET_Board.kicad_pcb

## KiCad design kicad/Unipolar_FET_Board/Unipolar_FET_Board.kicad_pcb (2024-07-29)

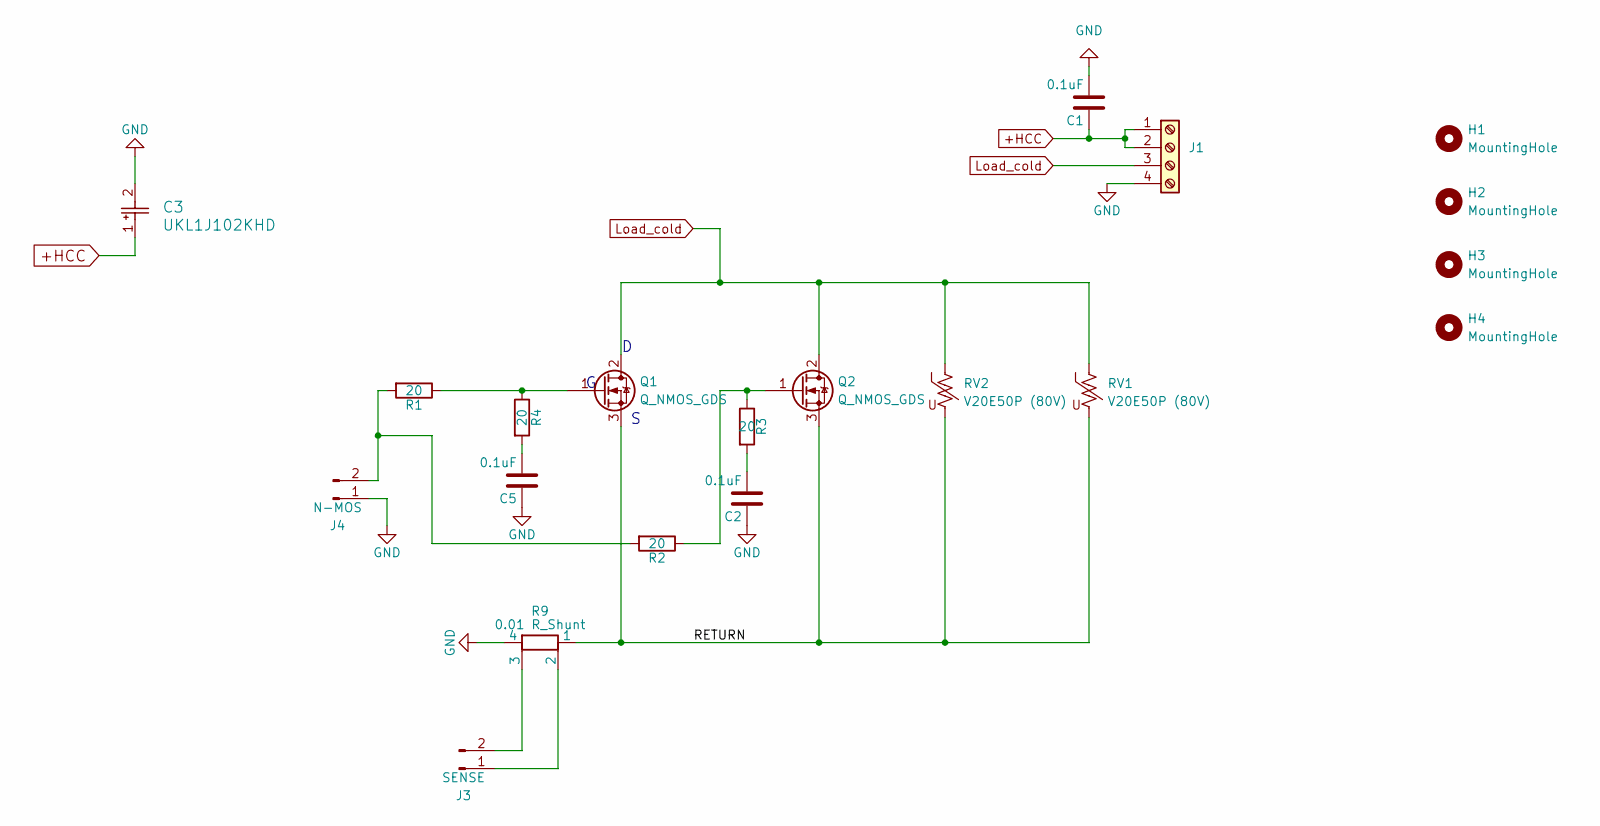
[picture p32: schematic Unipolar_FET_Board.kicad_sch]

Parts:
C1, C2, C5: 0.1uF; C_0603_1608Metric; MPN C0603C104J5RACAUTO; DIGIKEY PARTNO 399-6853-1-ND
C3: UKL1J102KHD; CP_Radial_D18.0mm_P7.50mm; PARTNO UKL1J102KHD; DIGIKEY 493-16867-ND
H1, H2, H3, H4: MountingHole; MountingHole_4mm
J1: Screw_Terminal_01x04; CONN_2453710000; PARTNO 2453710000; DIGIKEY 2453710000-ND
J3: SENSE; PinHeader_1x02_P2.54mm_Vertical
J4: N-MOS; PinHeader_1x02_P2.54mm_Vertical
Q1, Q2: Q_NMOS_GDS; PowerMOS; PARTNO IXFN520N075T2; DIGIKEY IXFN520N075T2-ND
R1, R2, R3, R4: 20; R_0603_1608Metric_Pad0.98x0.95mm_HandSolder; DIGIKEY PARTNO P20.00BYCT-ND
R9: 0.01 R_Shunt; SIP-4-ShuntResistor-Riedon; PARTNO PCS-0R01D1; DIGIKEY 696-PCS-0R01D1-ND
RV1, RV2: V20E50P (80V); RV_Disc_D15.5mm_W7.5mm_P7.5mm; PARTNO V20E50P; DIGIKEY F6901-ND

Connections:
+HCC: C1.1, C3.1, J1.1, J1.2
/RETURN: Q1.3 (S), Q2.3 (S), R9.1, RV1.2, RV2.2
GND: C1.2, C2.1, C3.2, C5.1, J1.4, J4.1, R9.4
Load_cold: J1.3, Q1.2 (D), Q2.2 (D), RV1.1, RV2.1
unnamed: C2.2, R3.2
unnamed: C5.2, R4.2
unnamed: J3.1, R9.2
unnamed: J3.2, R9.3
unnamed: J4.2, R1.2, R2.2
unnamed: Q1.1 (G), R1.1, R4.1
unnamed: Q2.1 (G), R2.1, R3.1

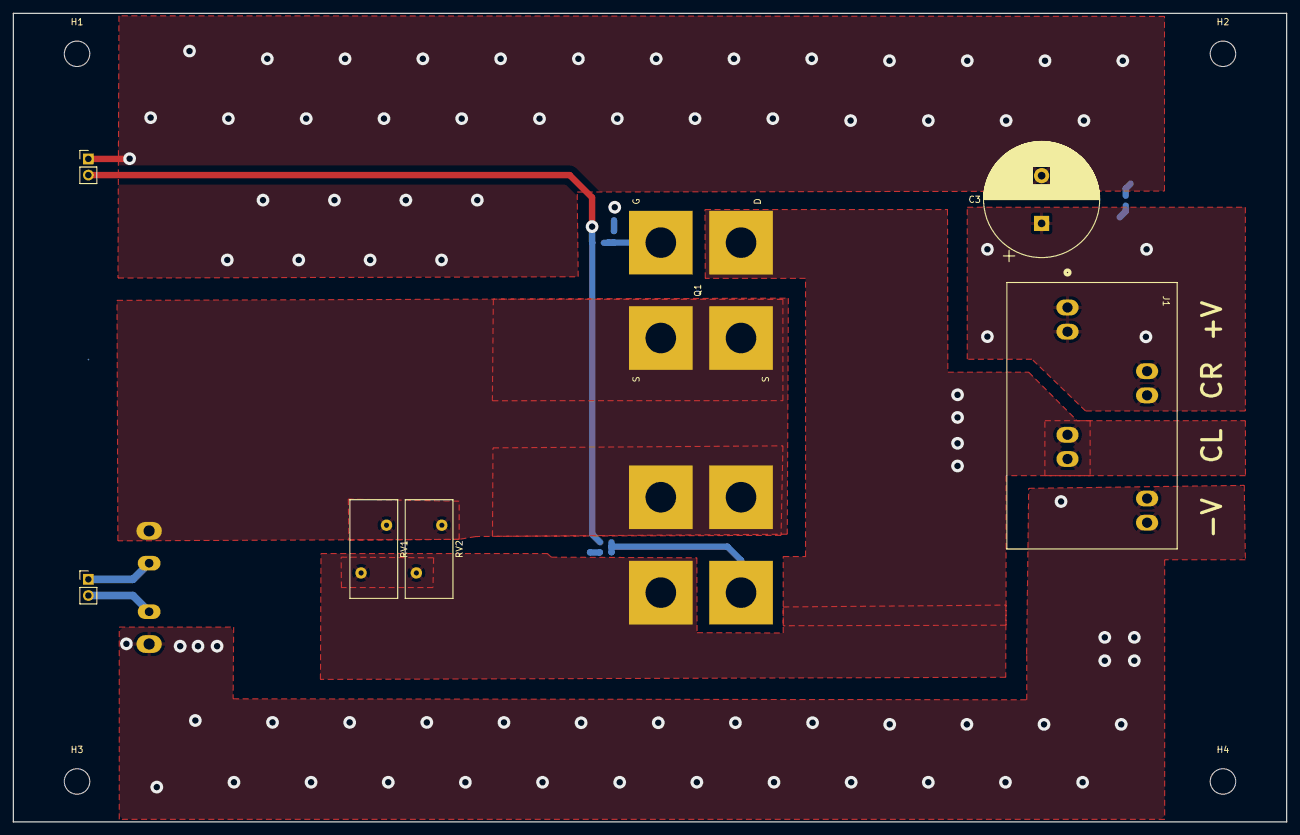
[picture p33: board Unipolar_FET_Board.kicad_pcb from above]

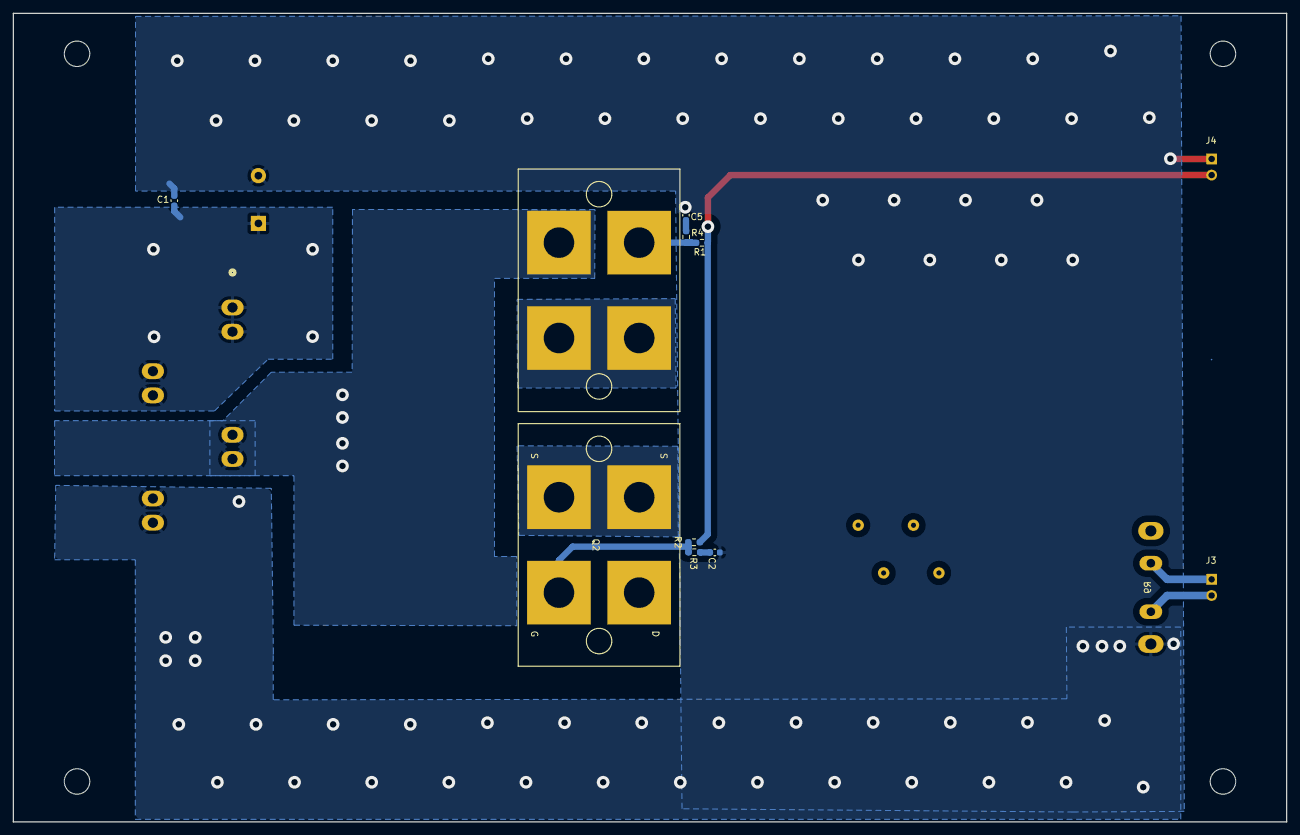
[picture p34: board Unipolar_FET_Board.kicad_pcb from below]

Board: 2 copper layers, 200.0 x 127.0 mm, 20 parts (9 on the bottom side), 11 nets.
