Boop-Noddle/20A-bipolar-current-source/kicad/H-bridge/H_bridge.kicad_pcb

## KiCad design kicad/H-bridge/H_bridge.kicad_pcb (2024-07-26)

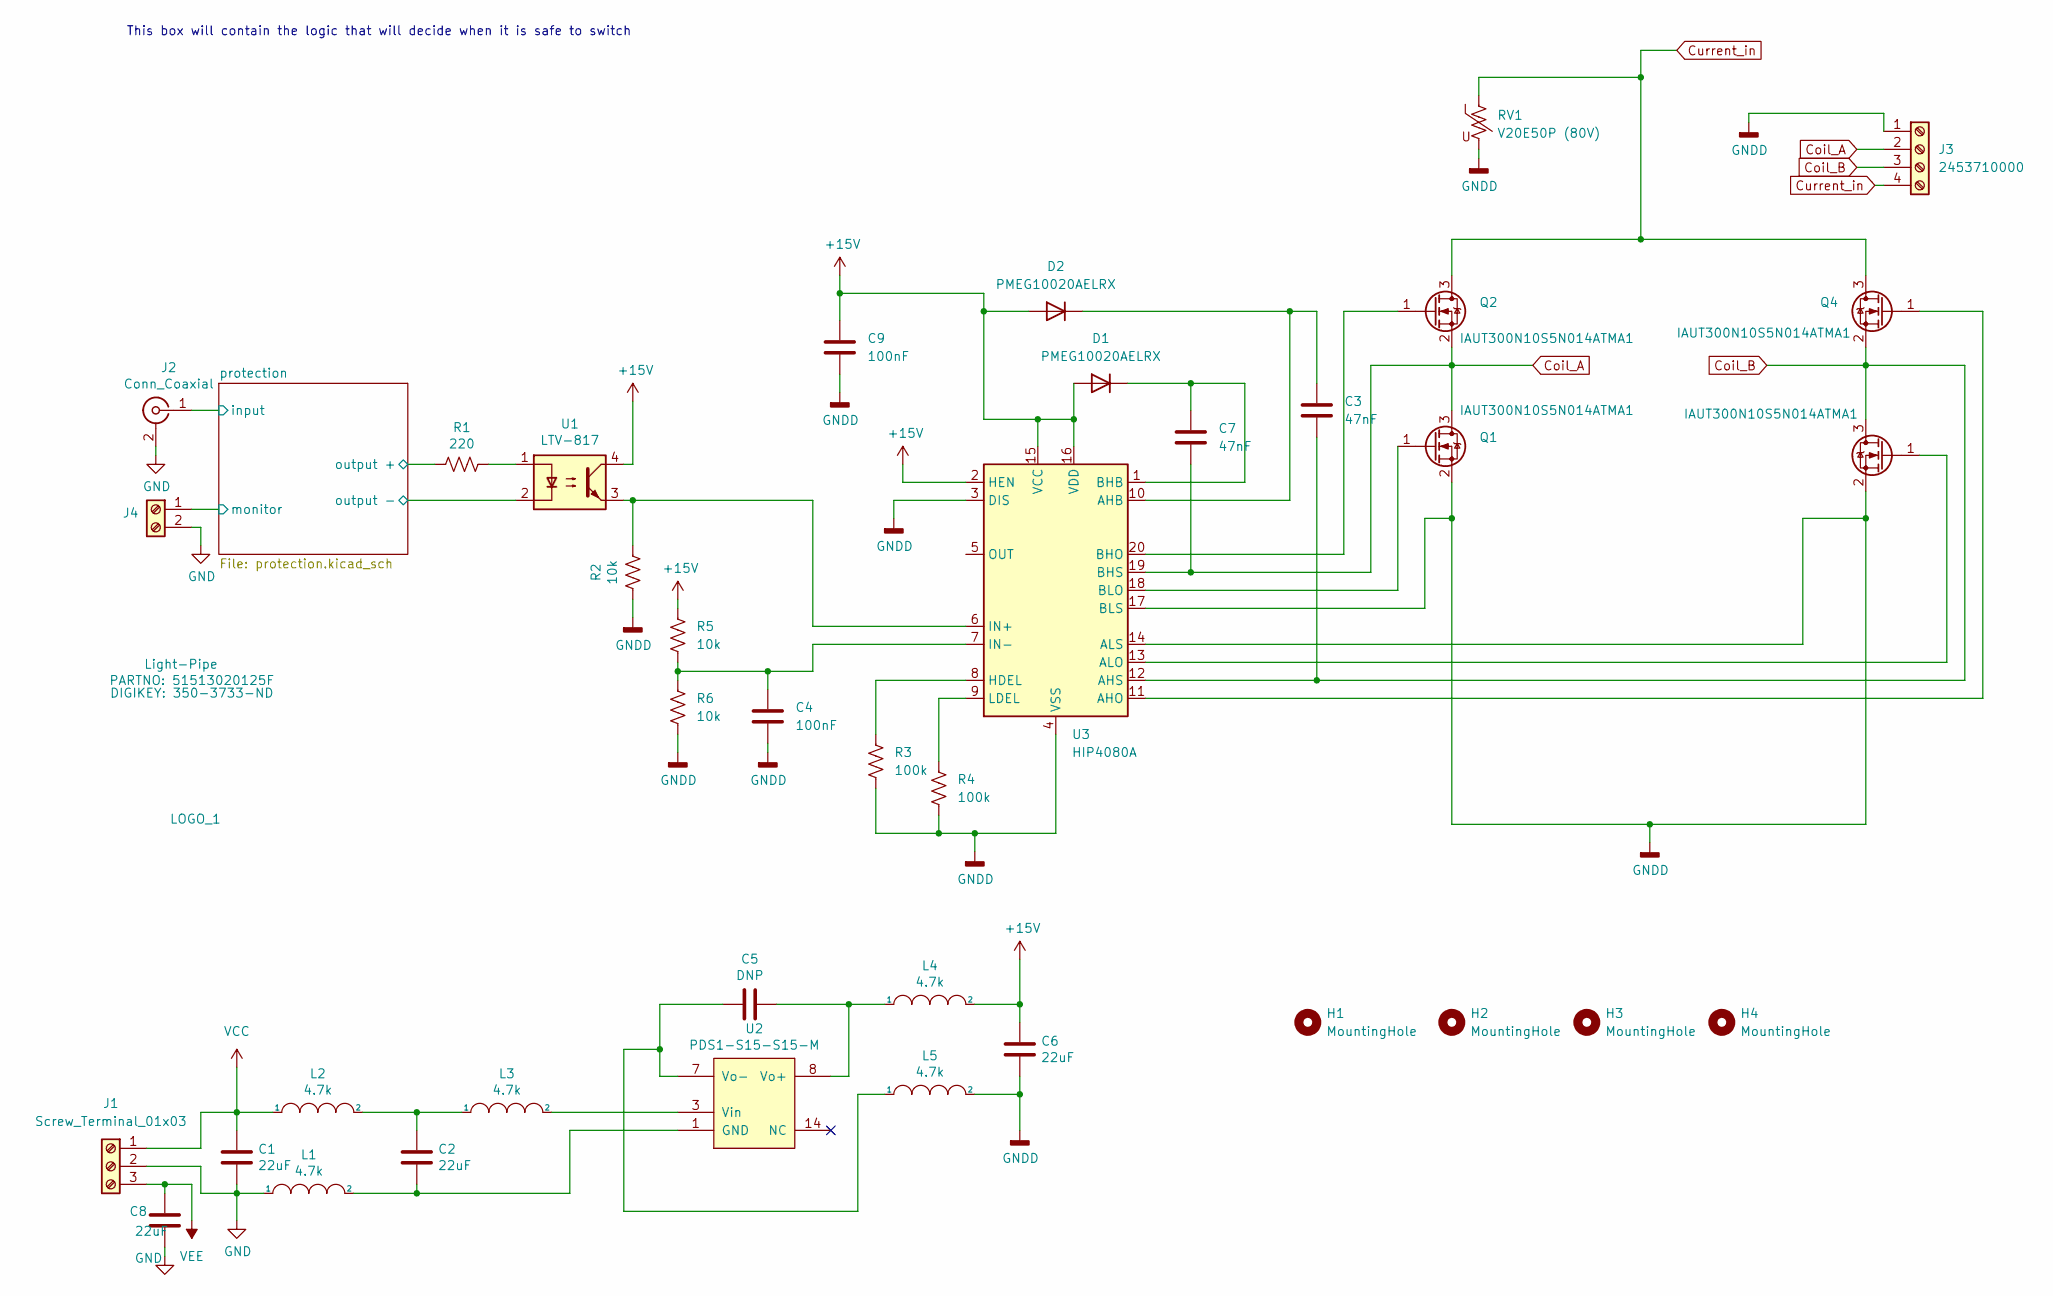
[picture p35: schematic H_bridge.kicad_sch]

Parts:
BOM1: Light-Pipe; PARTNO 51513020125F; DIGIKEY 350-3733-ND
C1, C2, C6, C8: 22uF; C_0805_2012Metric; PARTNO C2012X5R1V226M125AC; DIGIKEY 445-14428-1-ND
C3, C7: 47nF; C_0805_2012Metric; PARTNO C0805C473K2RECAUTO; DIGIKEY 399-C0805C473K2RECAUTOCT-ND
C4, C9: 100nF; C_0805_2012Metric; PARTNO CC0805KRX7R9BB104; DIGIKEY 311-1140-1-ND
C5: DNP; C_0805_2012Metric
D1, D2: PMEG10020AELRX; Nexperia_CFP3_SOD-123W; PARTNO PMEG10020AELRX; DIGIKEY 1727-2283-1-ND
H1, H2, H3, H4: MountingHole; MountingHole_3.5mm
J1: Screw_Terminal_01x03; TerminalBlock_4Ucon_1x03_P3.50mm_Horizontal; PARTNO 1984620; DIGIKEY 277-1722-ND
J2: Conn_Coaxial; BNC_Socket_TYCO-AMP; PARTNO 5227161-7; DIGIKEY A32260-ND
J3: 2453710000; CONN_2453710000; PARTNO 2453710000; DIGIKEY 2453710000-ND
J4: Screw_Terminal_01x02; TerminalBlock_4Ucon_1x02_P3.50mm_Horizontal; PARTNO 1984617; DIGIKEY 277-1721-ND
L1, L2, L3, L4, L5: 4.7k; L_0805; PARTNO BLM21HE472SN1L; DIGIKEY 490-BLM21HE472SN1LCT-ND
LOGO_1: JQI-Logo
Q1, Q2, Q3, Q4: IAUT300N10S5N014ATMA1; Infineon_PG-HSOF-8-1_ThermalVias; PARTNO IAUT300N10S5N014ATMA1; DIGIKEY 448-IAUT300N10S5N014ATMA1CT-ND
R1: 220; R_0805; PARTNO CRGCQ0805F220R; DIGIKEY A129741CT-ND
R2, R5, R6: 10k; R_0805_2012Metric; PARTNO CRGCQ0805F10K; DIGIKEY A129761CT-ND
R3, R4: 100k; R_0805_2012Metric; PARTNO CRG0805F100K; DIGIKEY A106052CT-ND
RV1: V20E50P (80V); RV_Disc_D15.5mm_W7.5mm_P7.5mm; PARTNO V20E50P; DIGIKEY F6901-ND
U1: LTV-817; DIP-4_W10.16mm_LongPads; PARTNO LTV-817; DIGIKEY 160-1366-5-ND
U2: PDS1-S15-S15-M; DCDC-Conv_muRata_NXE2SxxxxMC; PARTNO PDS1-S15-S15-M; DIGIKEY 102-4546-ND
U3: HIP4080A; SO-20_12.8x7.5mm_P1.27mm; PARTNO HIP4080AIBZT; DIGIKEY HIP4080AIBZTCT-ND

Connections:
+15V: C6.2, C9.1, D1.2 (A), D2.2 (A), L4.2, R5.1, U1.4, U3.2 (HEN), U3.15 (VCC), U3.16 (VDD)
/protection/input: J2.1 (In); also elsewhere on the board
/protection/monitor: J4.1; also elsewhere on the board
/protection/output +: R1.2; also elsewhere on the board
/protection/output -: U1.2; also elsewhere on the board
Coil_A: C7.2, J3.2, Q1.3 (D), Q2.2 (S), U3.19 (BHS)
Coil_B: C3.2, J3.3, Q3.3 (D), Q4.2 (S), U3.12 (AHS)
Current_in: J3.4, Q2.3 (D), Q4.3 (D), RV1.1
GND: C1.2, C8.2, J1.2, J2.2 (Ext), J4.2, L1.1; also elsewhere on the board
GNDD: C4.2, C6.1, C9.2, J3.1, L5.2, Q1.2 (S), Q3.2 (S), R2.2, R3.2, R4.2, R6.2, RV1.2, U3.3 (DIS), U3.4 (VSS), U3.14 (ALS), U3.17 (BLS)
unnamed: C2.1, L2.2, L3.1
unnamed: C7.1, D1.1 (K), U3.1 (BHB)
unnamed: C3.1, D2.1 (K), U3.10 (AHB)
unnamed: Q1.1 (G), U3.18 (BLO)
unnamed: Q2.1 (G), U3.20 (BHO)
unnamed: Q3.1 (G), U3.13 (ALO)
unnamed: Q4.1 (G), U3.11 (AHO)
unnamed: R1.1, U1.1
unnamed: C2.2, L1.2, U2.1 (GND)
unnamed: L3.2, U2.3 (Vin)
unnamed: C5.1, L4.1, U2.8 (Vo+)
unnamed: C5.2, L5.1, U2.7 (Vo-)
unnamed: R3.1, U3.8 (HDEL)
unnamed: R2.1, U1.3, U3.6 (IN+)
unnamed: C4.1, R5.2, R6.1, U3.7 (IN-)
unnamed: R4.1, U3.9 (LDEL)
VEE: C8.1, J1.3; also elsewhere on the board

Notes on the sheet:
This box will contain the logic that will decide when it is safe to switch

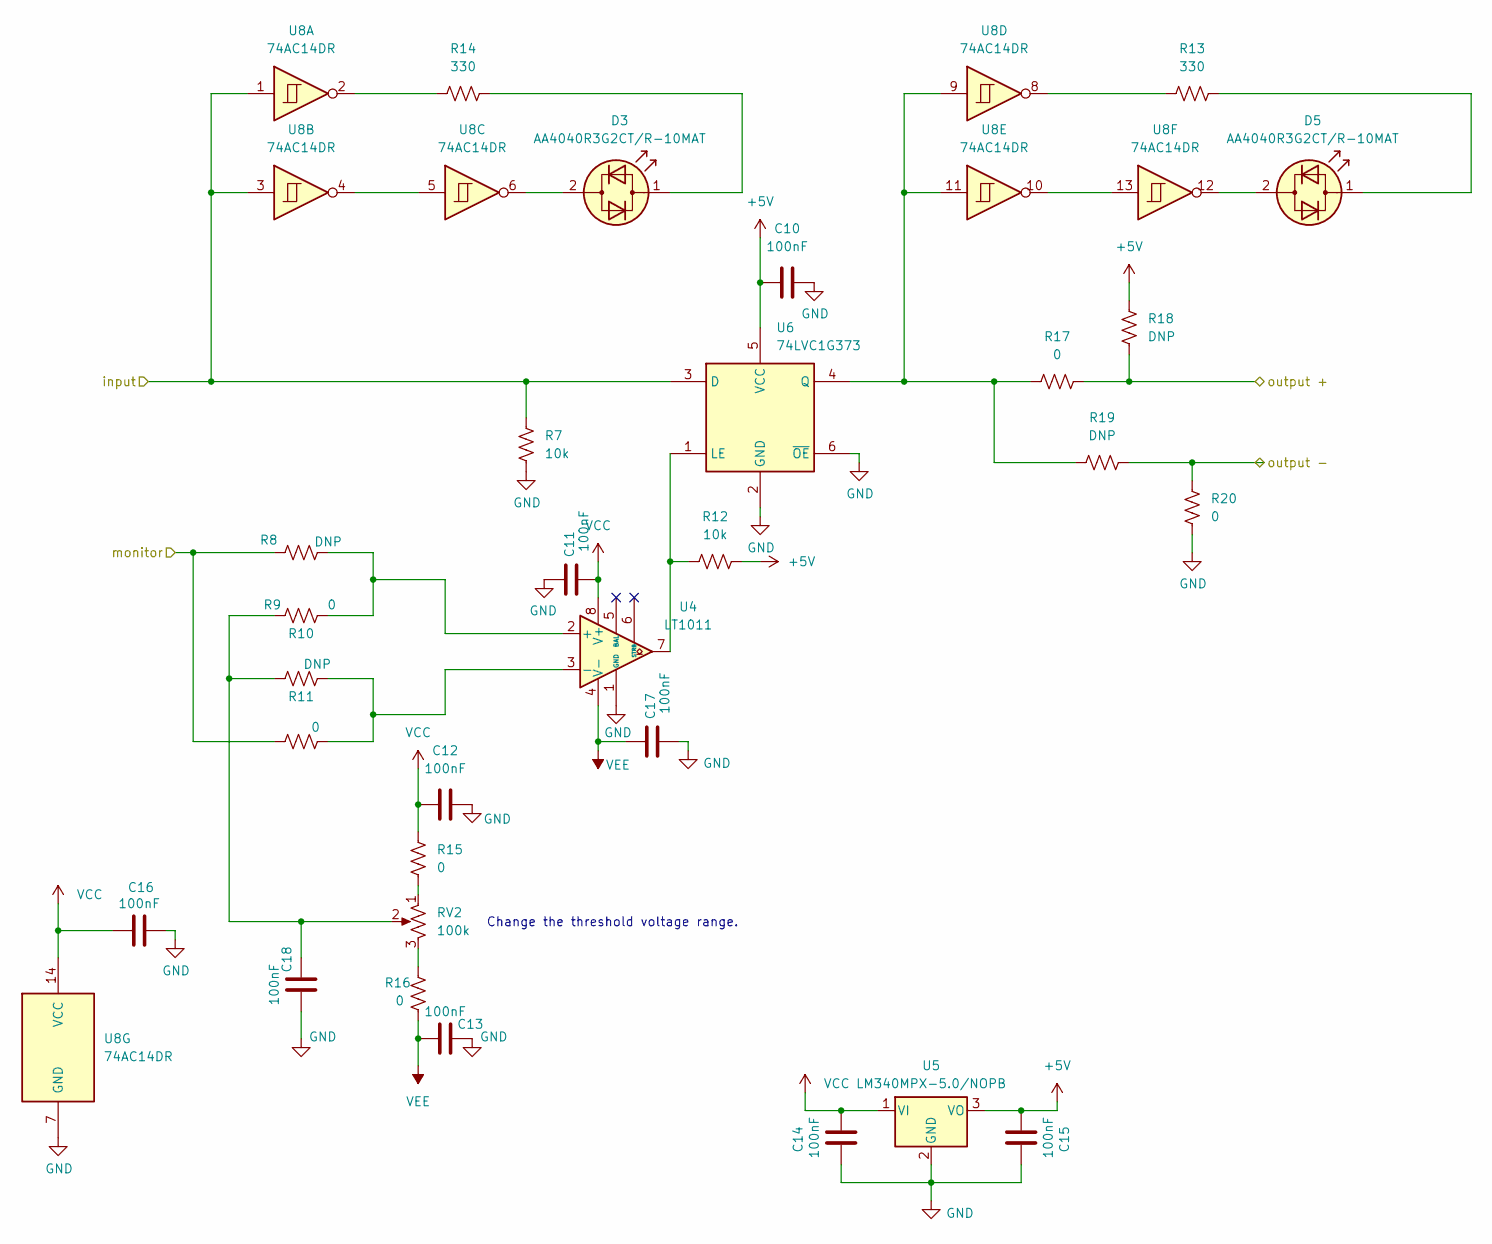
[picture p36: schematic protection.kicad_sch]

Parts:
C10, C11, C12, C13, C14, C15, C16, C17, C18: 100nF; C_0805_2012Metric; PARTNO CC0805KRX7R9BB104; DIGIKEY 311-1140-1-ND
D3, D5: AA4040R3G2CT/R-10MAT; LED_boomerang; PARTNO AA4040R3G2CT/R-10MAT; DIGIKEY 754-AA4040R3G2CT/R-10MATCT-ND
R7, R12: 10k; R_0805_2012Metric; PARTNO CRGCQ0805F10K; DIGIKEY A129761CT-ND
R8, R10, R18, R19: DNP; R_0805_2012Metric
R9, R11, R15, R16, R17, R20: 0; R_0805_2012Metric; PARTNO CRG0805ZR; DIGIKEY A106066CT-ND
R13, R14: 330; R_0805_2012Metric; PARTNO CRGCQ0805F330R; DIGIKEY A129743CT-ND
RV2: 100k; Potentiometer_Bourns_3266Y_Vertical; PARTNO 3266Y-1-104LF; DIGIKEY 3266Y-1-104LF-ND
U4: LT1011; SO-8_3.9x4.9mm_P1.27mm; PARTNO LT1011CS8#PBF; DIGIKEY LT1011CS8#PBF-ND
U5: LM340MPX-5.0/NOPB; SOT-223-3_TabPin2; PARTNO LM340MPX-5.0/NOPB; DIGIKEY LM340MPX-5.0/NOPBCT-ND
U6: 74LVC1G373; SOT-363_SC-70-6; PARTNO SN74LVC1G373DCKR; DIGIKEY 296-18775-1-ND
U8: 74AC14DR; SOIC-14_3.9x8.7mm_P1.27mm; PARTNO SN74AC14DR; DIGIKEY 296-4300-1-ND

Connections:
/protection/input: R7.1, U6.3 (D), U8.1, U8.3; also elsewhere on the board
/protection/monitor: R8.1, R11.1; also elsewhere on the board
/protection/output +: R17.2, R18.1; also elsewhere on the board
/protection/output -: R19.1, R20.2; also elsewhere on the board
GND: C10.2, C11.2, C12.2, C13.2, C14.1, C15.1, C16.1, C17.1, C18.1, R7.2, R20.1, U4.1 (GND), U5.2 (GND), U6.2 (GND), U6.6 (~OE), U8.7 (GND); also elsewhere on the board
unnamed: C18.2, R9.1, R10.1, RV2.2
unnamed: D3.2 (AK), U8.6
unnamed: D3.1 (KA), R14.2
unnamed: D5.2 (AK), U8.12
unnamed: D5.1 (KA), R13.2
unnamed: R13.1, U8.8
unnamed: R14.1, U8.2
unnamed: R15.1, RV2.1
unnamed: R16.2, RV2.3
unnamed: R8.2, R9.2, U4.2 (+)
unnamed: R10.2, R11.2, U4.3 (-)
unnamed: R12.1, U4.7, U6.1 (LE)
unnamed: R17.1, R19.2, U6.4 (Q), U8.9, U8.11
unnamed: U8.4, U8.5
unnamed: U8.10, U8.13
VEE: C13.1, C17.2, R16.1, U4.4 (V-); also elsewhere on the board

Notes on the sheet:
Change the threshold voltage range.

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
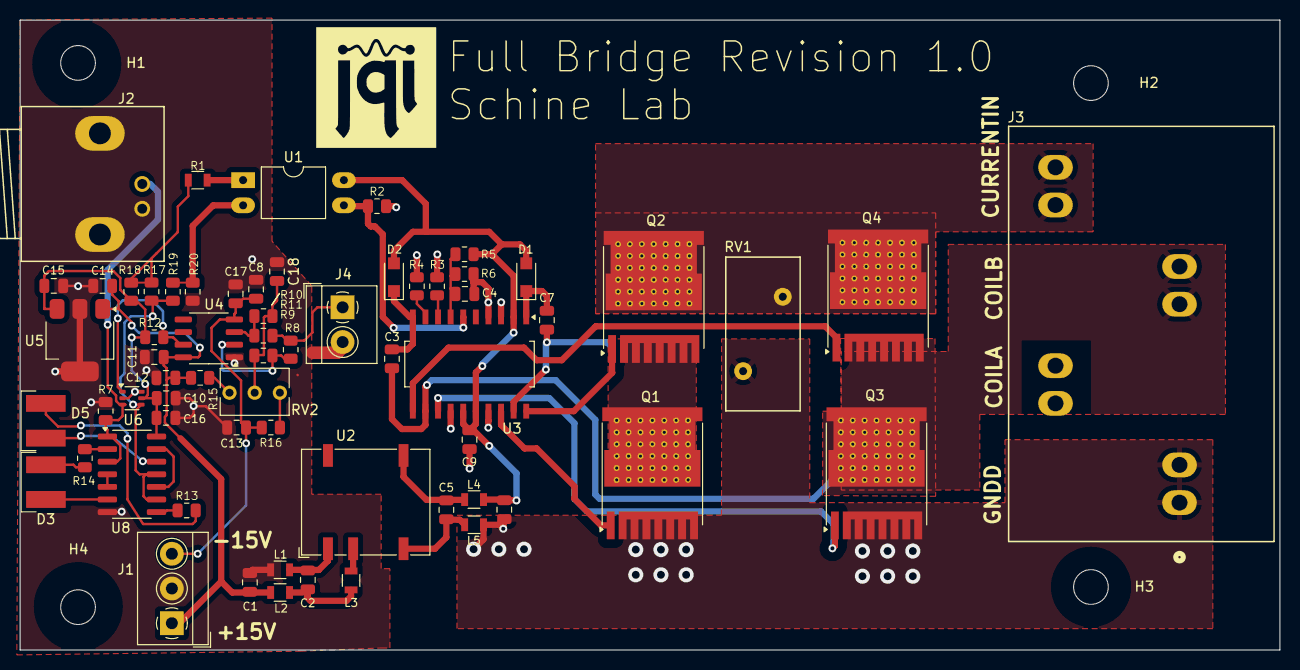
[picture p37: board H_bridge.kicad_pcb from above]

Board: 2 copper layers, 127.0 x 63.5 mm, 69 parts (0 on the bottom side), 44 nets.
