Boop-Noddle/20A-bipolar-current-source/(commit log)

2024-05-27 First iteration of the layout
    [H_bridge.kicad_pcb, H_bridge.kicad_sch]
2024-06-06 2nd iteration
    [H_bridge.kicad_pcb, H_bridge.kicad_sch]
2024-06-12 H_bridge circuit with current control ciruit added
    [H_bridge.kicad_pcb, H_bridge.kicad_sch]
2024-06-14 Fixed silkscreen placement
    [H_bridge.kicad_pcb]
2024-06-14 Added sub-circuit
    [protection.kicad_sch]
2024-06-18 Added C18, logo and other footprints
    [H_bridge.kicad_pcb, H_bridge.kicad_sch, protection.kicad_sch]
2024-06-19 Fixed error is MOS package assigment and added solder mask for manual tin pour for increased conductivity
    [H_bridge.kicad_pcb, H_bridge.kicad_sch, protection.kicad_sch]
2024-06-24 fixed connection error and added text
    [H_bridge.kicad_pcb]
2024-06-28 Aligned mountiing holes
    [H_bridge.kicad_pcb, H_bridge.kicad_sch, protection.kicad_sch]
2024-07-11 Unipolar Fet Board v1.0
    [Unipolar_FET_Board.kicad_pcb, Unipolar_FET_Board.kicad_sch]
2024-07-11 Added vias'
    [Unipolar_FET_Board.kicad_pcb]
2024-07-11 Added varistor and labesl for the connecters
    [Unipolar_FET_Board.kicad_pcb, Unipolar_FET_Board.kicad_sch]
2024-07-12 Parallel MOS with current sharing resistors
    Putting additional resistors in series with the source of each MOS is not necessary.
    Nonetheless I saved this partiular snapshot in case we want to pursuit this strategy to share the current
    [Unipolar_FET_Board.kicad_pcb, Unipolar_FET_Board.kicad_sch]
2024-07-26 15V output modification
    [Controller_supply.kicad_pcb, Controller_supply.kicad_sch]
2024-07-26 Trimportand INverter power supply fix, now connects to 5V
    [H_bridge.kicad_pcb]
2024-07-26 Added silkscreen
    [Controller_supply.kicad_pcb]
2024-07-29 The MOS and capacitors are now in the correct orientation
    [Unipolar_FET_Board.kicad_pcb, Unipolar_FET_Board.kicad_sch]
2024-07-29 Seperated zones
    [Controller_supply.kicad_pcb]
2025-05-27 Addtional Testing Data and reports
    [S10.CSV, S2.CSV, S4.CSV, S6.CSV, S8.CSV]
